etbikehome/Mech_Des_Ornithopter/Peer Critique 1.pdf

# Ornithopter

## Peer Critique 1

## What’s an Ornithopter

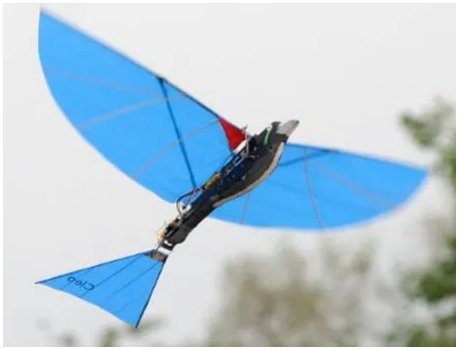
[picture p1: figure]

- A mechanical bird!
- Generates thrust by flapping its wings.
- Subsystems:
- Wings
- Wing Flapping Mech.
- Motor and Gearbox
- Tail

## Functional Requirements

1. Must be able to climb (this means thrust > drag)
2. Should be able to fly for at least 3 minutes on a charge.
3. Must generate its thrust by flapping its wings.
4. Should flap at a rate comparable to a similar size bird.
5. Must have wingspan ~1 meter or less.
6. Must be radio-controlled and maneuverable enough to be flown within the Olin soccer field.
7. Should be able to be re-assembled after a severe crash in 1 day or less.

## Specifications

1. Wing is 1m span by 0.2 m chord
2. From testing: wing draws 20W
3. 200g weight budget
a. From design manual 100W/kg for climb

## Gearbox

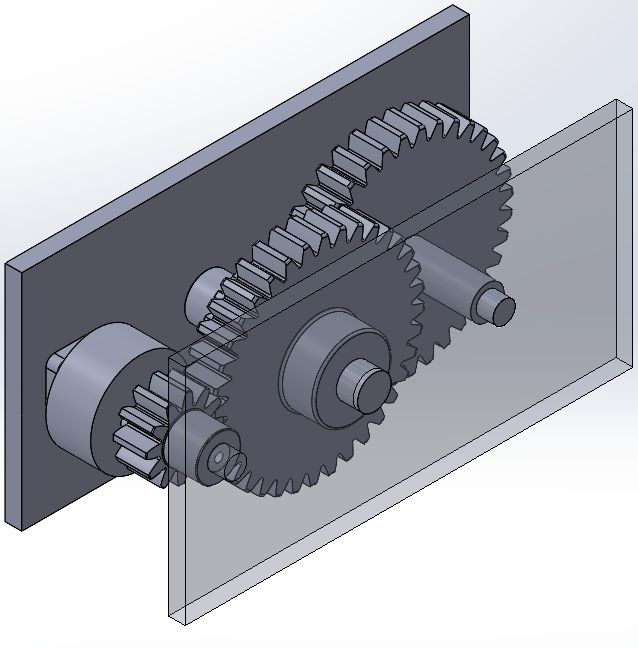
[picture p2: figure]

Requirements:

- Must output 20W at 3 flaps per second with wings attached.
- Must fit within 200g weight budget

Mechanics:

- Acts as fuselage, containing mounting points for other subsystems
- Uses a gear ratio of 9:1 determined from motor power and current calculations, in a 2x3:1 configuration to minimize weight.

## Flapping Mechanism

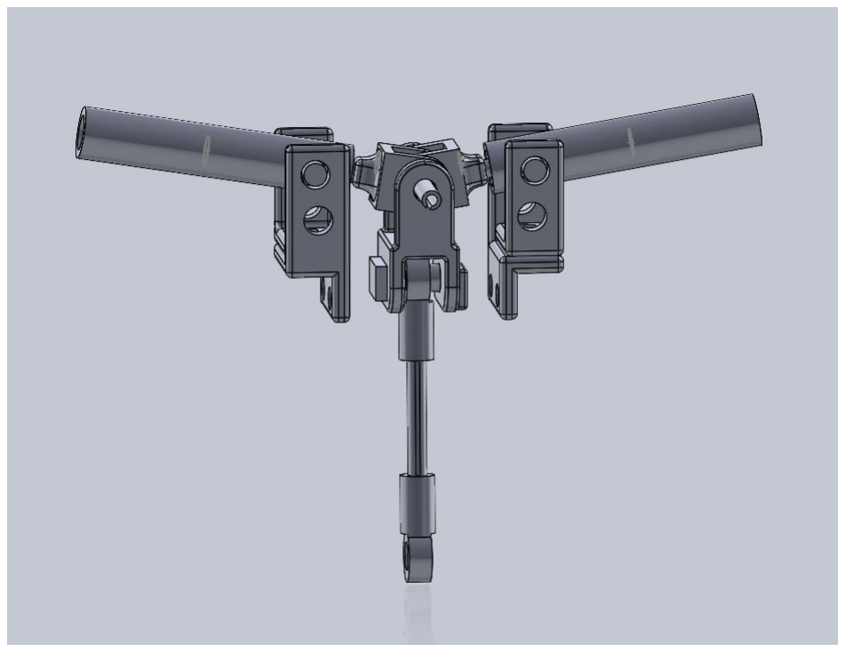
[picture p3: figure]

Requirements:

- Must output 20W at 3 flaps per second with wings attached.
- Must fit within 200g weight budget
- Must provide mostly symmetric flapping

Feedback Points:

- Figuring out better materials (or whether current materials are sufficient)
- Whether heat will be an issue at high speeds
- Maintaining symmetry - is extra support needed? How to implement?

## Tail

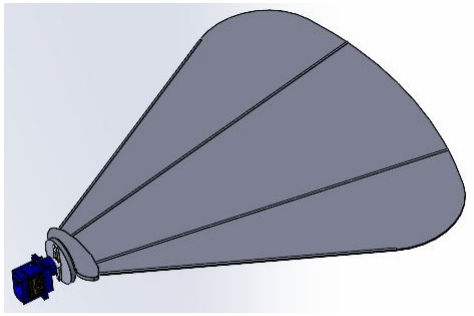
[picture p4: figure]

Requirements

- Must fit within 200g weight budget
- Must be able to rotate to turn
- Must provide stability to flying

## Weight Budget

Calculated using recommended power-weight ratio: 200g

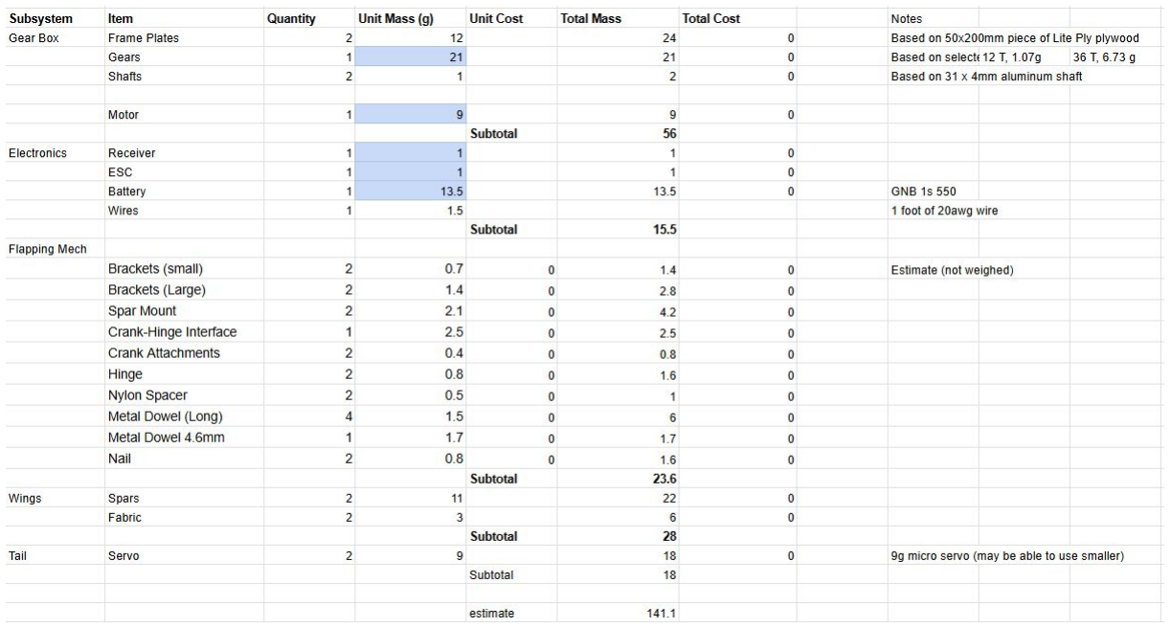
[picture p5: figure]

## Timeline

- We have not yet assembled most hardware (since benchmarking), have a few prototypes made
- We plan to begin assembly next week, aiming to complete it before Thanksgiving break.
