etbikehome/Mech_Des_Ornithopter/Tail/Ornithopter Tail Assembly.SLDASM

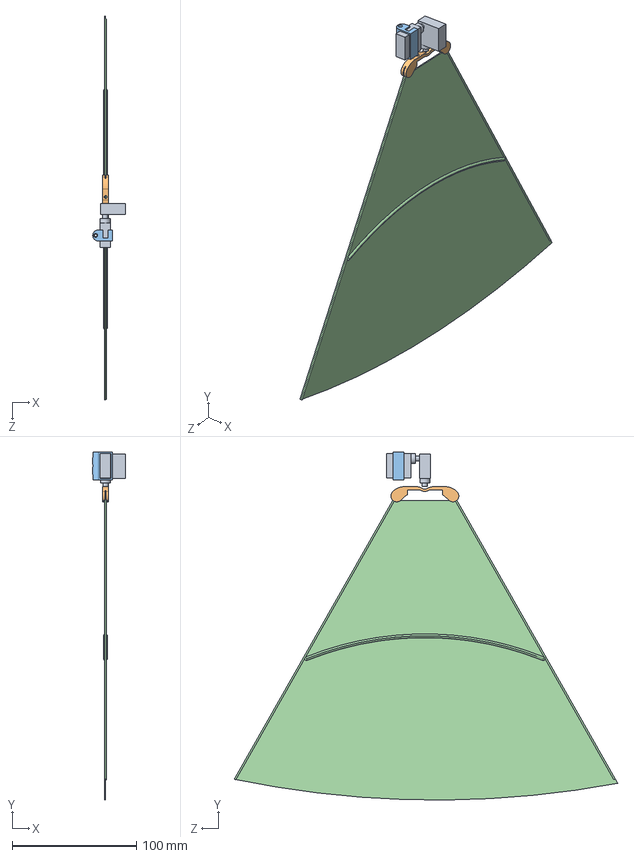
[picture p6: CAD file, 2024-12-20]
Tail/Ornithopter Tail Assembly.SLDASM
26.2 x 280.2 x 308.9 mm
Tail_Ornithopter
Tail Clip rod
Ornithopter Tail Holder 2 with split and support
5.5g Servo x 2
