etbikehome/Mech_Des_Ornithopter/Tail/SG90 - Micro Servo 9g - Tower Pro.SLDASM

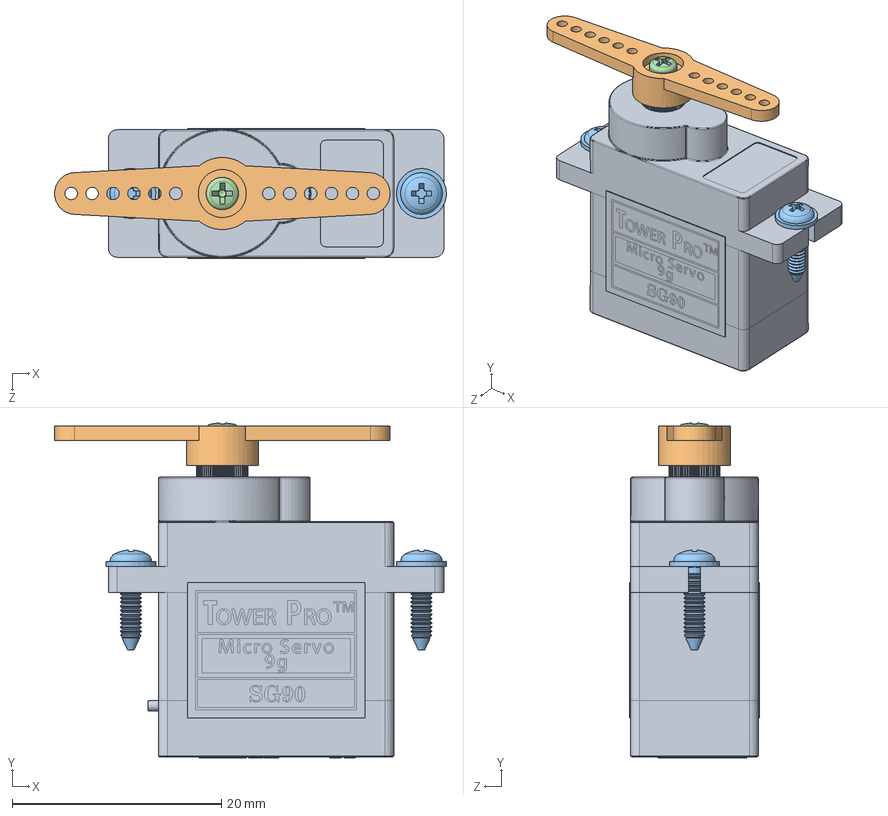
[picture p7: CAD file, 2024-11-21]
Tail/SG90 - Micro Servo 9g - Tower Pro.SLDASM
37.5 x 32.0 x 12.4 mm
SG90 - Micro Servo 9g - Tower Pro.1
SG90 - Micro Servo 9g - Tower Pro.3
SG90 - Micro Servo 9g - Tower Pro.5 x 2
SG90 - Micro Servo 9g - Tower Pro.6
