etbikehome/Mech_Des_Ornithopter/gearbox/Gearbox.SLDASM

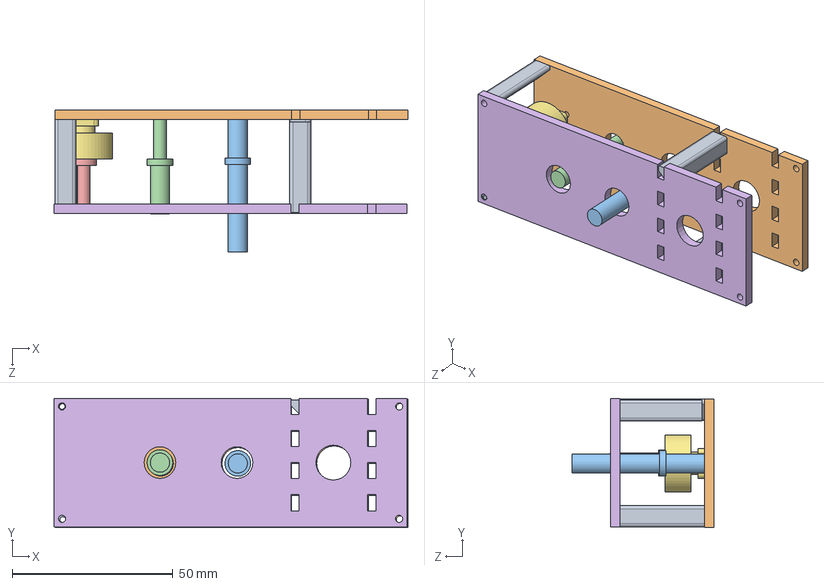
[picture p8: CAD file, 2024-11-30]
gearbox/Gearbox.SLDASM
110.2 x 40.2 x 44.2 mm
motor_1404
sideplateA
motor_adaptor_shaft
step_shaft
single_6mm_shaft
sideplateB
gearbox_standoff x 4
