etbikehome/Mech_Des_Ornithopter/gearbox/Gears/sideplateA.DXF

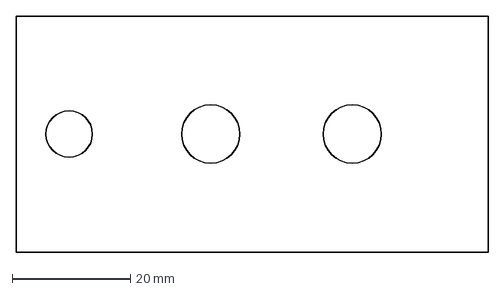
[picture p9: CAD file, 2024-11-18]
gearbox/Gears/sideplateA.DXF
80.0 x 40.0 mm
