etbikehome/Mech_Des_Ornithopter/Hinge Flapping Mechanism/flapping_mech_frames_v2.SLDPRT

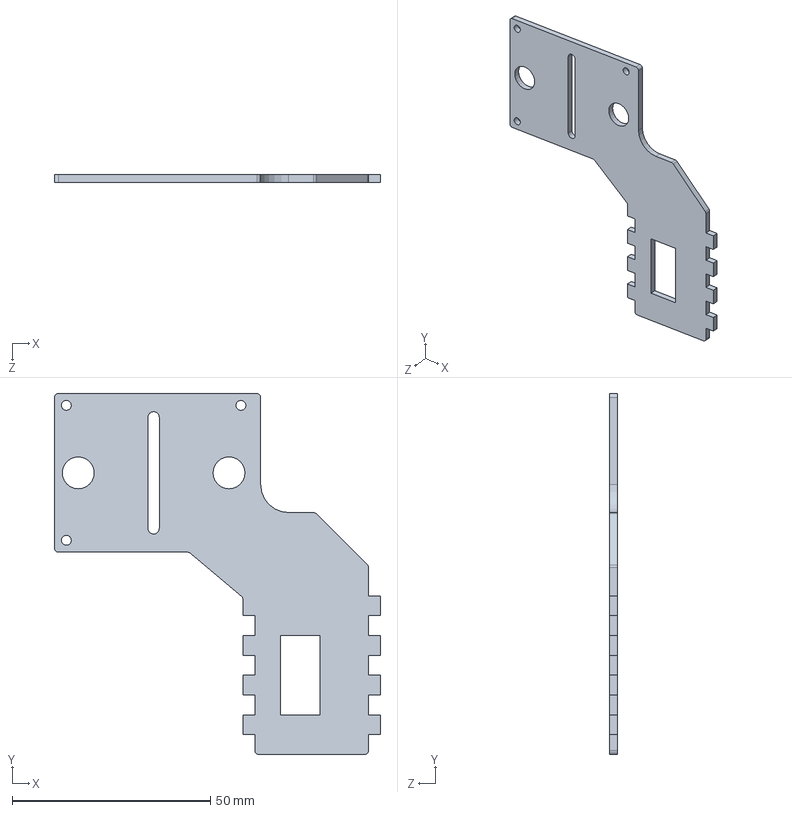
[picture p10: CAD file, 2024-12-19]
Hinge Flapping Mechanism/flapping_mech_frames_v2.SLDPRT
82.2 x 91.0 x 2.00 mm
