etbikehome/Mech_Des_Ornithopter/Tail/Ornithopter Tail Holder 2 with split and support.SLDPRT

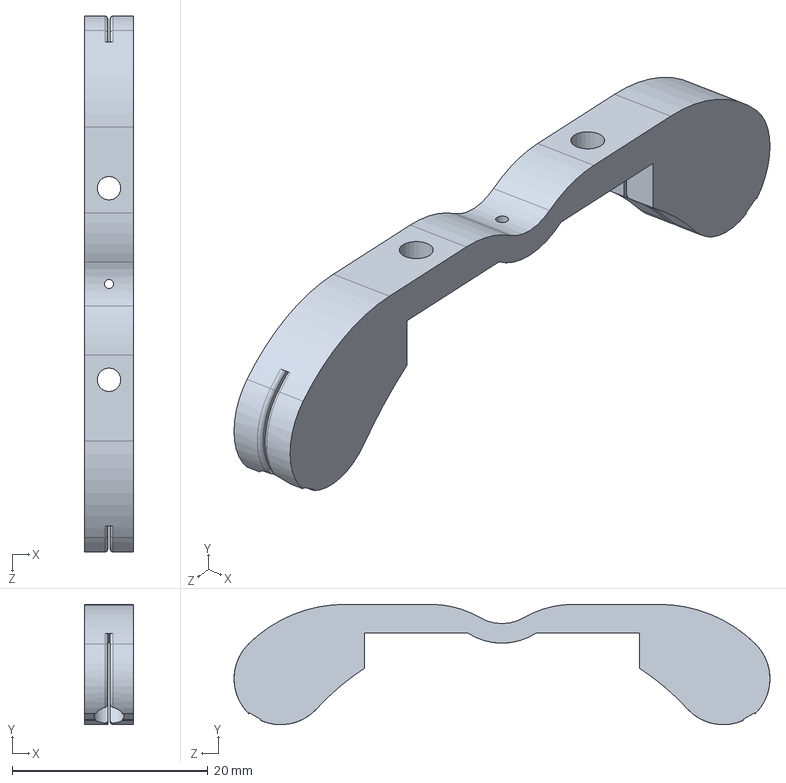
[picture p11: CAD file, 2024-12-14]
Tail/Ornithopter Tail Holder 2 with split and support.SLDPRT
5.00 x 12.3 x 54.8 mm
