etbikehome/Mech_Des_Ornithopter/gearbox/sideplateA.SLDPRT

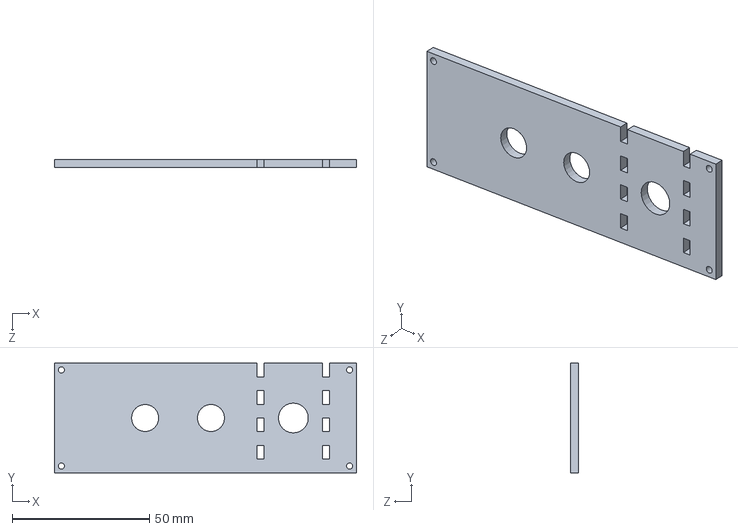
[picture p12: CAD file, 2024-12-13]
gearbox/sideplateA.SLDPRT
110.0 x 40.0 x 3.00 mm
