etbikehome/Mech_Des_Ornithopter/Hinge Flapping Mechanism/spar_hinge_interface_v3.SLDPRT

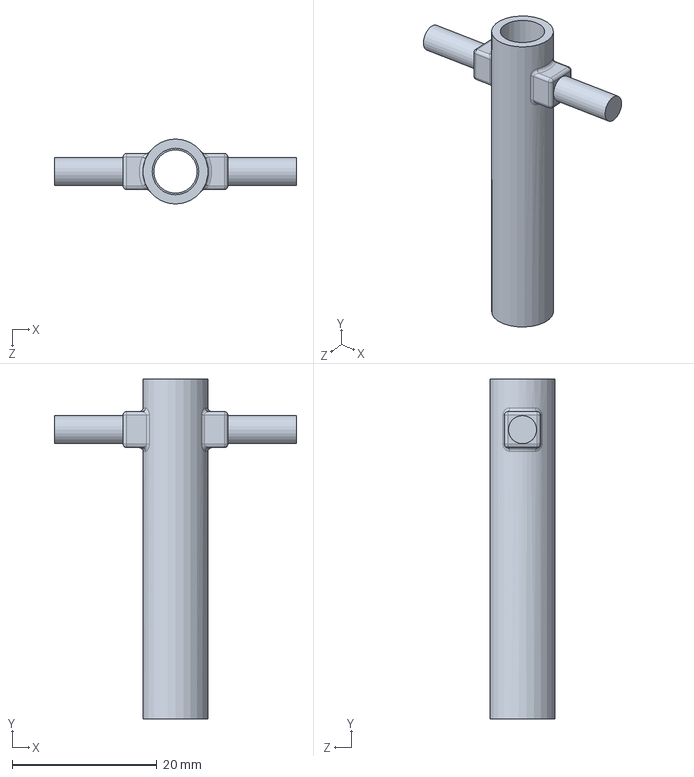
[picture p13: CAD file, 2024-12-18]
Hinge Flapping Mechanism/spar_hinge_interface_v3.SLDPRT
33.5 x 47.0 x 9.00 mm
