etbikehome/Mech_Des_Ornithopter/Tail/Tail_Ornithopter.SLDPRT

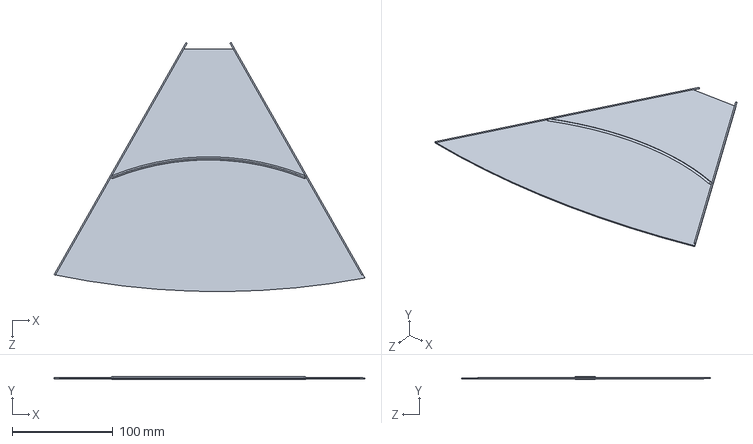
[picture p14: CAD file, 2024-12-14]
Tail/Tail_Ornithopter.SLDPRT
308.9 x 3.00 x 247.4 mm
