etbikehome/Mech_Des_Ornithopter/gearbox/gearbox_standoff.SLDPRT

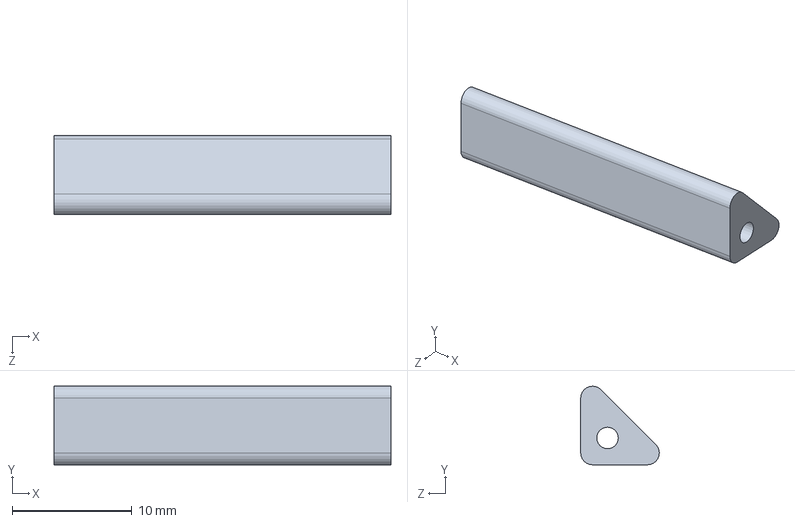
[picture p15: CAD file, 2024-12-13]
gearbox/gearbox_standoff.SLDPRT
28.2 x 6.59 x 6.59 mm
