etbikehome/Mech_Des_Ornithopter/Hinge Flapping Mechanism/plate_connector_tail_mount.SLDPRT

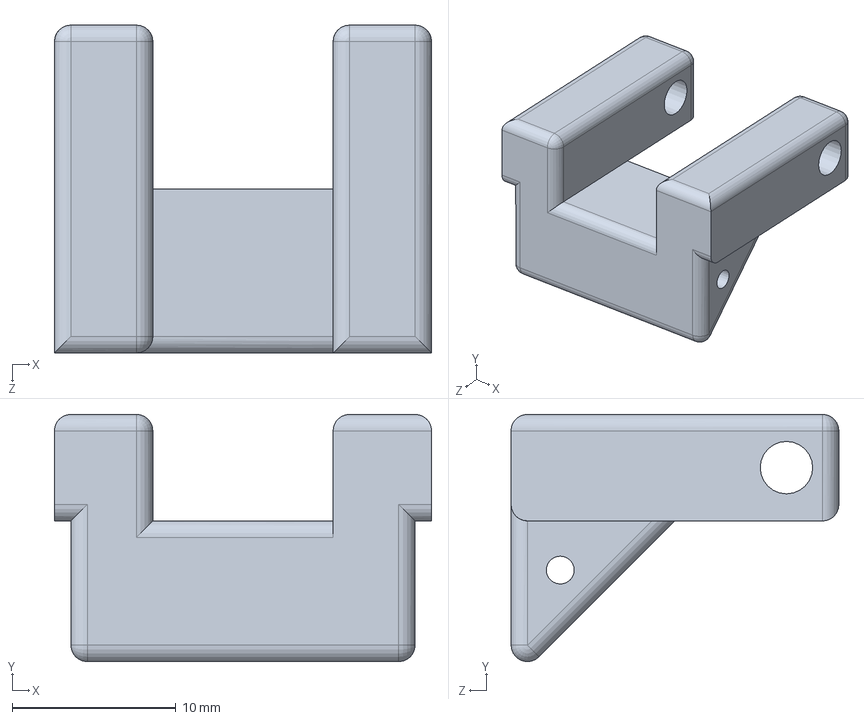
[picture p16: CAD file, 2024-12-11]
Hinge Flapping Mechanism/plate_connector_tail_mount.SLDPRT
23.0 x 15.1 x 20.0 mm
