etbikehome/Mech_Des_Ornithopter/Tail/5.5g Servo.SLDPRT

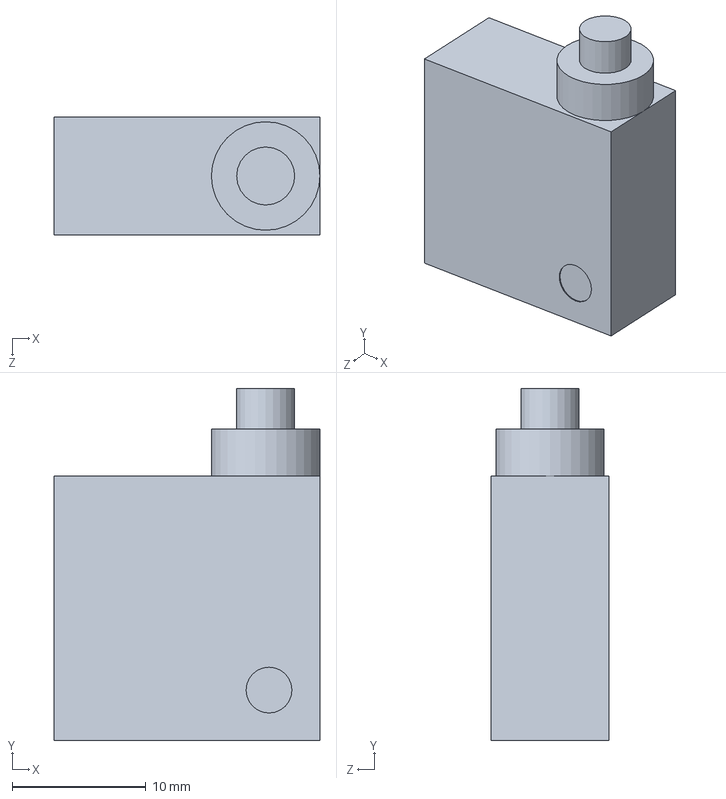
[picture p17: CAD file, 2024-12-13]
Tail/5.5g Servo.SLDPRT
19.9 x 26.4 x 8.80 mm
