etbikehome/Mech_Des_Ornithopter/gearbox/motor_1404.SLDPRT

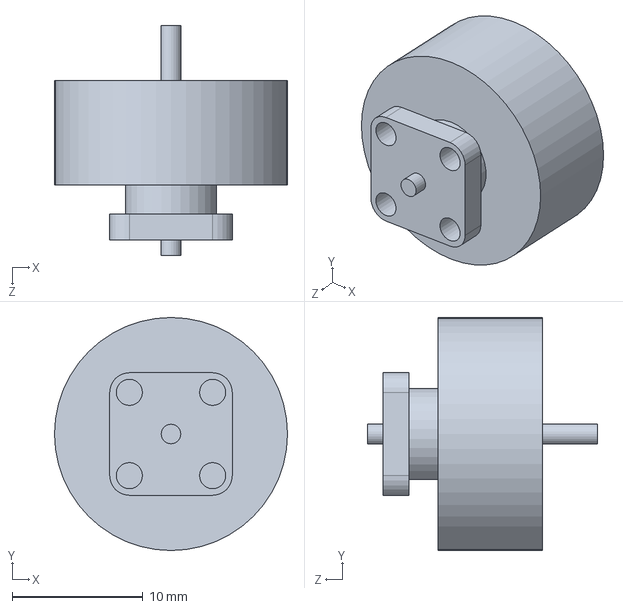
[picture p18: CAD file, 2024-12-09]
gearbox/motor_1404.SLDPRT
17.8 x 17.8 x 17.6 mm
