etbikehome/Mech_Des_Ornithopter/Hinge Flapping Mechanism/metal_crank_cap.SLDPRT

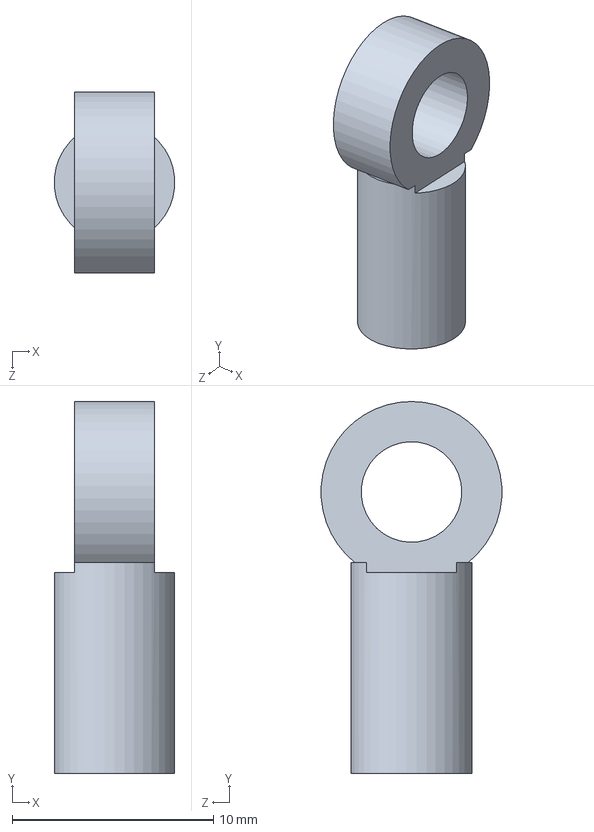
[picture p19: CAD file, 2024-12-11]
Hinge Flapping Mechanism/metal_crank_cap.SLDPRT
5.98 x 18.5 x 8.98 mm
