etbikehome/Mech_Des_Ornithopter/Tail/tail_rod.SLDPRT

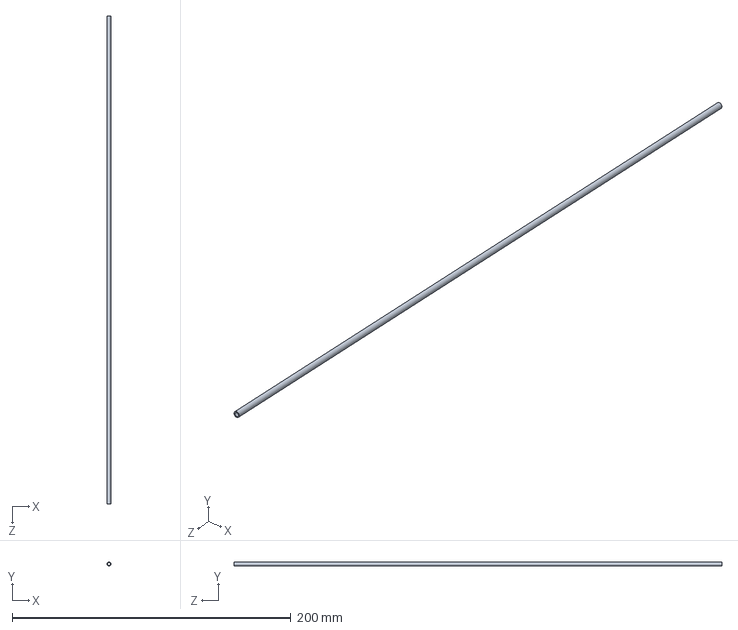
[picture p20: CAD file, 2024-12-13]
Tail/tail_rod.SLDPRT
3.00 x 3.00 x 350.0 mm
