etbikehome/Mech_Des_Ornithopter/gearbox/EMAX 2004 MOTOR.sldprt

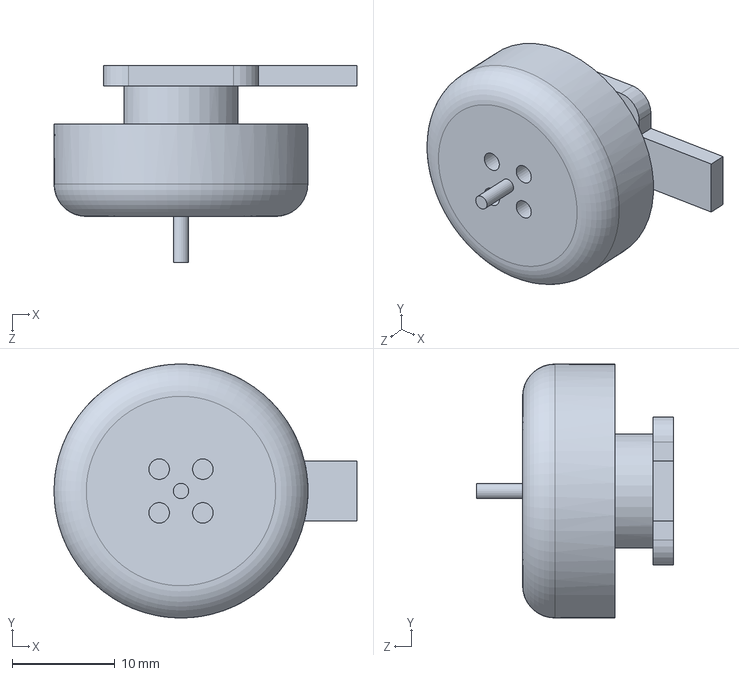
[picture p21: CAD file, 2024-12-09]
gearbox/EMAX 2004 MOTOR.sldprt
29.5 x 24.7 x 19.2 mm
