etbikehome/Mech_Des_Ornithopter/Hinge Flapping Mechanism/flapping_mech_frames_v2_no_hole.SLDPRT

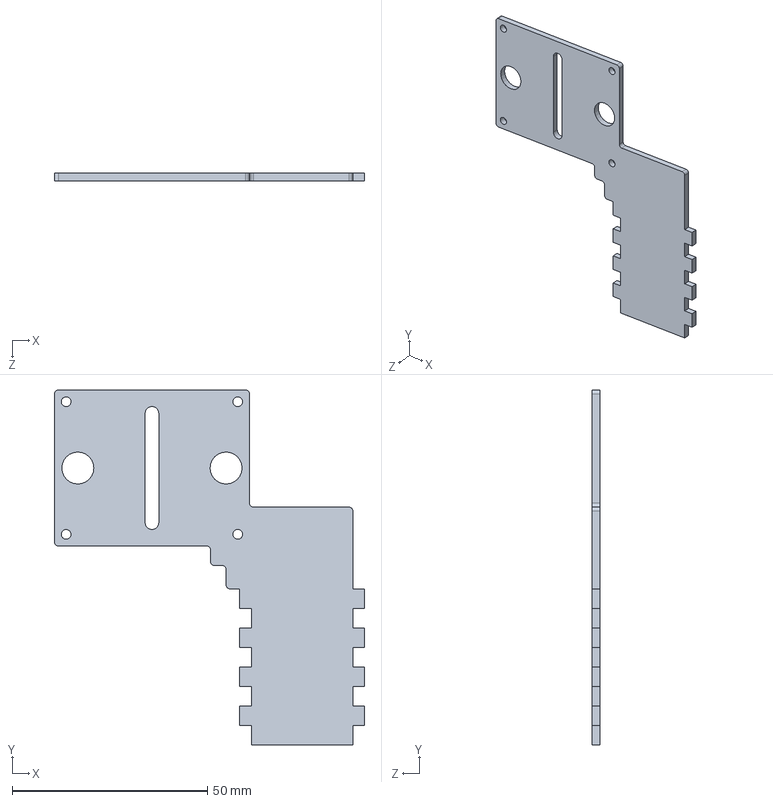
[picture p22: CAD file, 2024-12-05]
Hinge Flapping Mechanism/flapping_mech_frames_v2_no_hole.SLDPRT
79.5 x 91.0 x 2.00 mm
