etbikehome/Mech_Des_Ornithopter/Tail/Tail Clip rod.SLDPRT

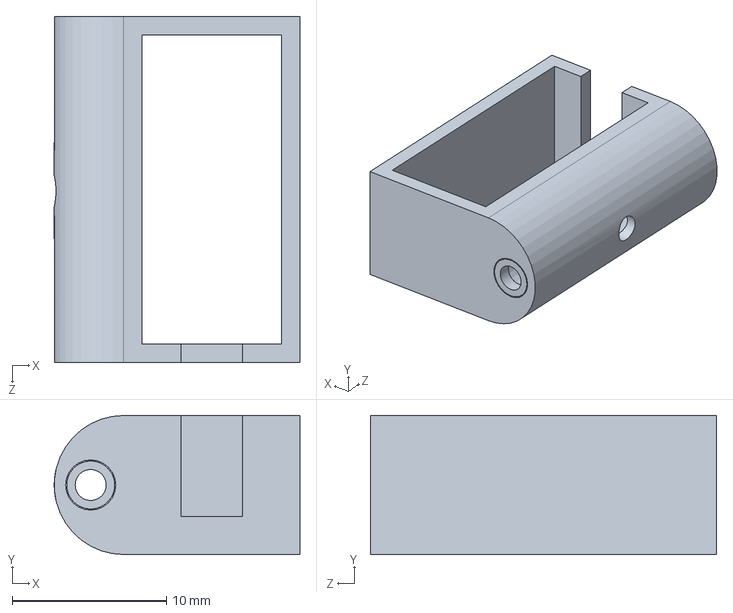
[picture p23: CAD file, 2024-12-13]
Tail/Tail Clip rod.SLDPRT
15.9 x 9.00 x 22.4 mm
