etbikehome/Mech_Des_Ornithopter/gearbox/4mm_shaft_bushing.SLDPRT

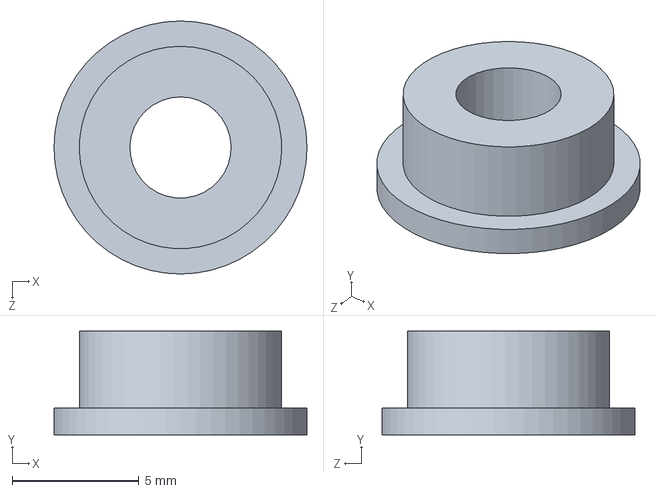
[picture p24: CAD file, 2024-12-09]
gearbox/4mm_shaft_bushing.SLDPRT
10.0 x 4.10 x 10.0 mm
