etbikehome/Mech_Des_Ornithopter/Hinge Flapping Mechanism/wing_fabric.SLDPRT

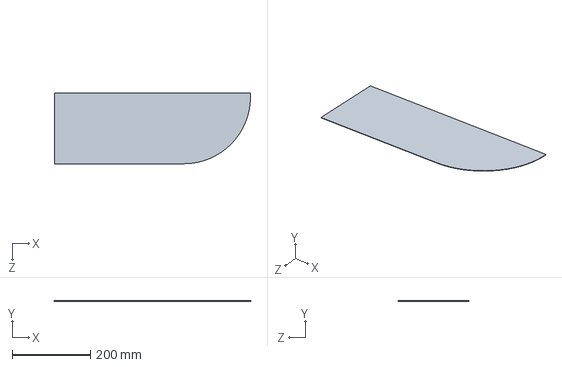
[picture p25: CAD file, 2024-12-05]
Hinge Flapping Mechanism/wing_fabric.SLDPRT
500.0 x 1.00 x 180.0 mm
