etbikehome/Mech_Des_Ornithopter/gearbox/sideplateB.SLDPRT

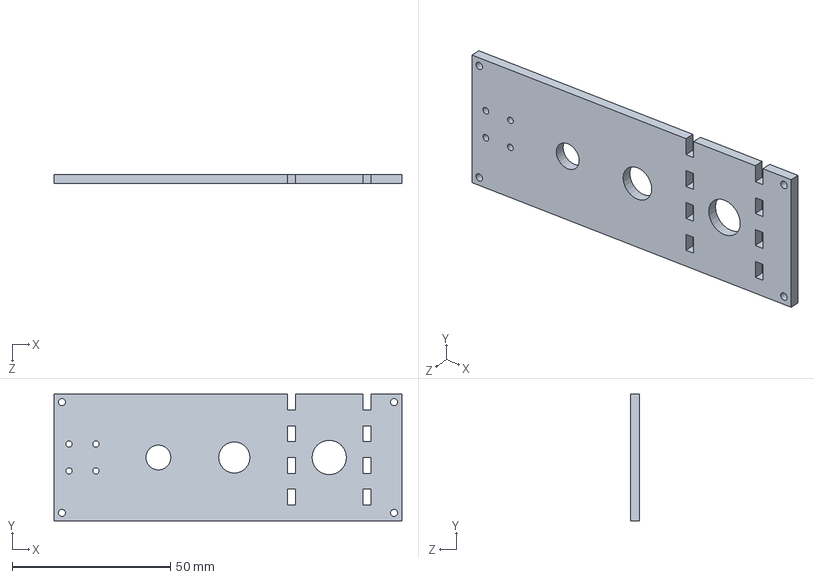
[picture p26: CAD file, 2024-12-09]
gearbox/sideplateB.SLDPRT
110.0 x 40.0 x 3.00 mm
