etbikehome/Mech_Des_Ornithopter/Tail/Ornithopter Tail Holder.SLDPRT

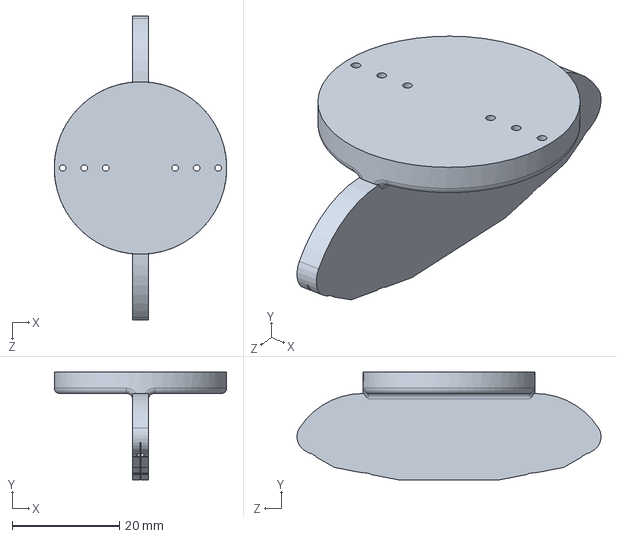
[picture p27: CAD file, 2024-11-18]
Tail/Ornithopter Tail Holder.SLDPRT
32.1 x 20.1 x 56.6 mm
