etbikehome/Mech_Des_Ornithopter/gearbox/8mm_shaft_bushing.SLDPRT

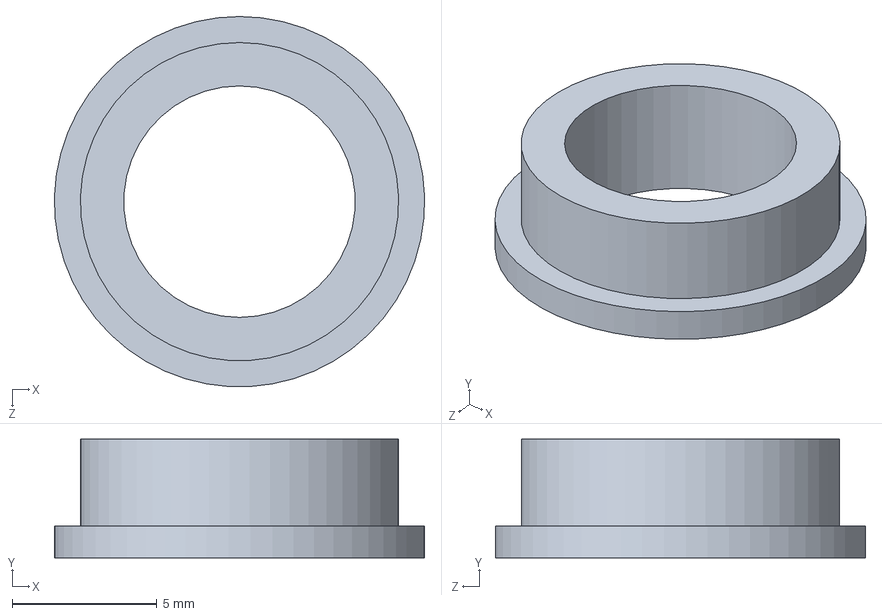
[picture p28: CAD file, 2024-12-09]
gearbox/8mm_shaft_bushing.SLDPRT
12.8 x 4.10 x 12.8 mm
