etbikehome/Mech_Des_Ornithopter/Hinge Flapping Mechanism/crank_v2.SLDPRT

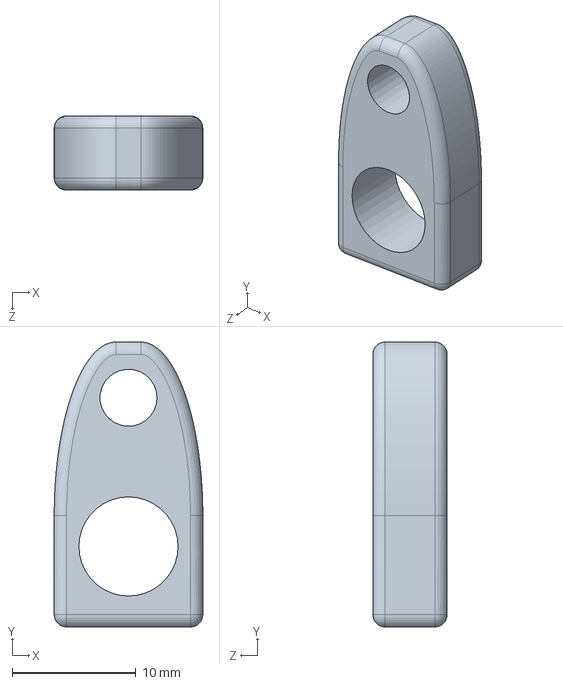
[picture p29: CAD file, 2024-12-04]
Hinge Flapping Mechanism/crank_v2.SLDPRT
12.0 x 23.0 x 6.00 mm
