etbikehome/Mech_Des_Ornithopter/Tail/SG90 - Micro Servo 9g - Tower Pro.5.SLDPRT

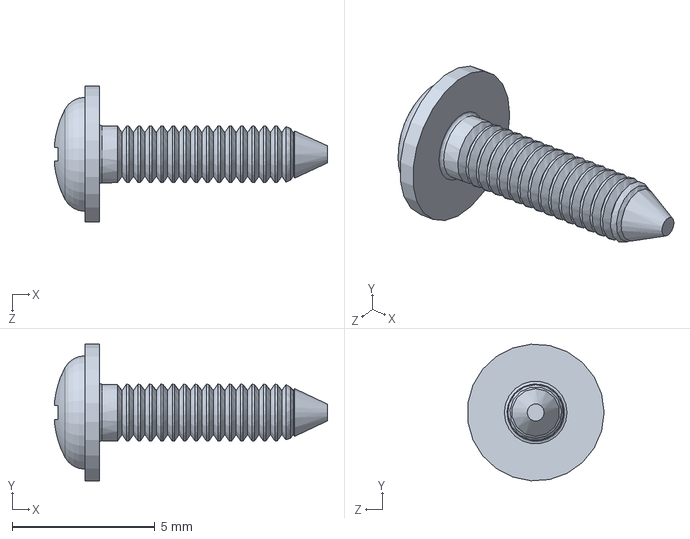
[picture p30: CAD file, 2024-11-18]
Tail/SG90 - Micro Servo 9g - Tower Pro.5.SLDPRT
9.57 x 4.79 x 4.78 mm
