etbikehome/Mech_Des_Ornithopter/gearbox/6mm_shaft_bushing.SLDPRT

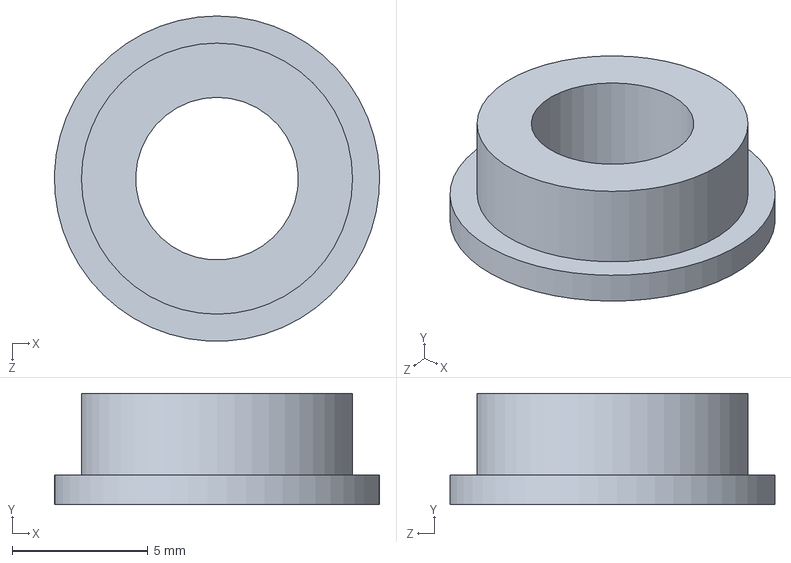
[picture p31: CAD file, 2024-12-09]
gearbox/6mm_shaft_bushing.SLDPRT
12.0 x 4.10 x 12.0 mm
