etbikehome/Mech_Des_Ornithopter/Hinge Flapping Mechanism/plate_connector.SLDPRT

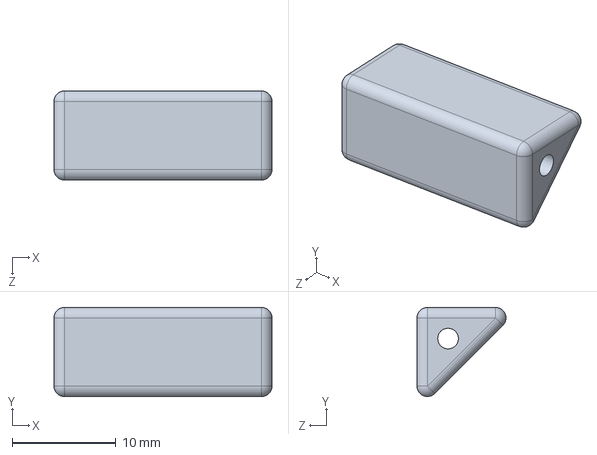
[picture p32: CAD file, 2024-12-04]
Hinge Flapping Mechanism/plate_connector.SLDPRT
21.0 x 8.59 x 8.59 mm
