etbikehome/Mech_Des_Ornithopter/Tail/SG90 - Micro Servo 9g - Tower Pro.6.SLDPRT

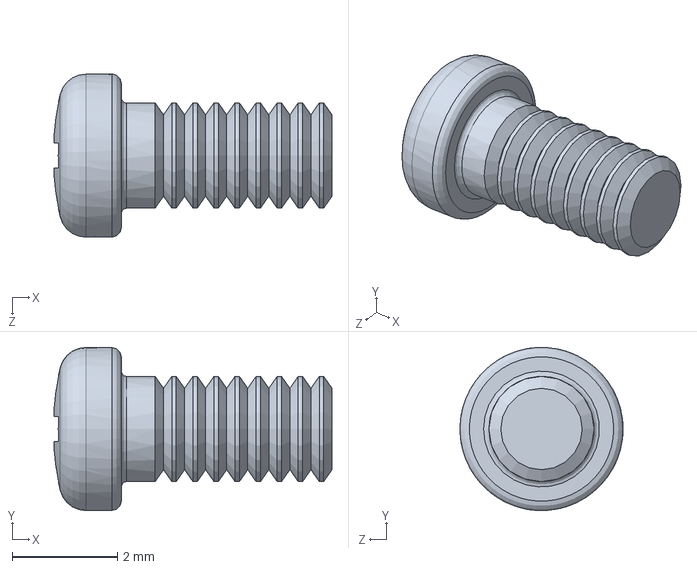
[picture p33: CAD file, 2024-11-18]
Tail/SG90 - Micro Servo 9g - Tower Pro.6.SLDPRT
5.28 x 3.10 x 3.10 mm
