etbikehome/Mech_Des_Ornithopter/gearbox/final_stage_shaft.SLDPRT

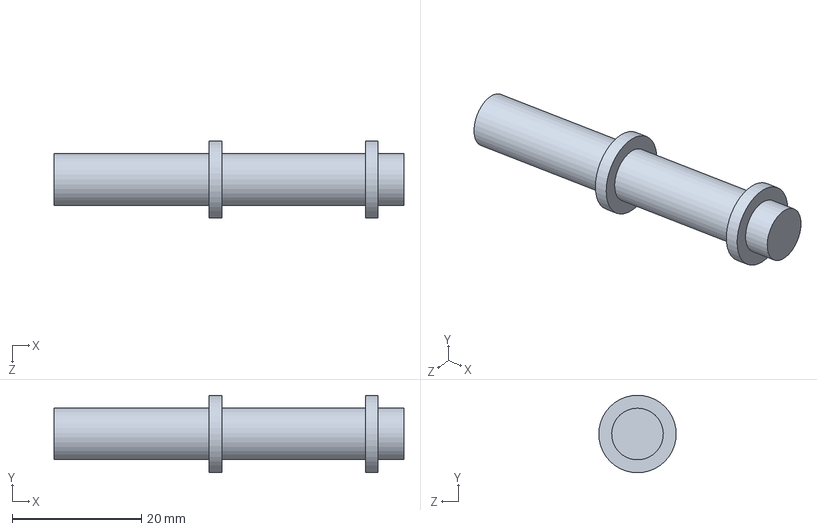
[picture p34: CAD file, 2024-12-05]
gearbox/final_stage_shaft.SLDPRT
54.2 x 12.0 x 12.0 mm
