etbikehome/Mech_Des_Ornithopter/Hinge Flapping Mechanism/crank_linkage_drive.SLDPRT

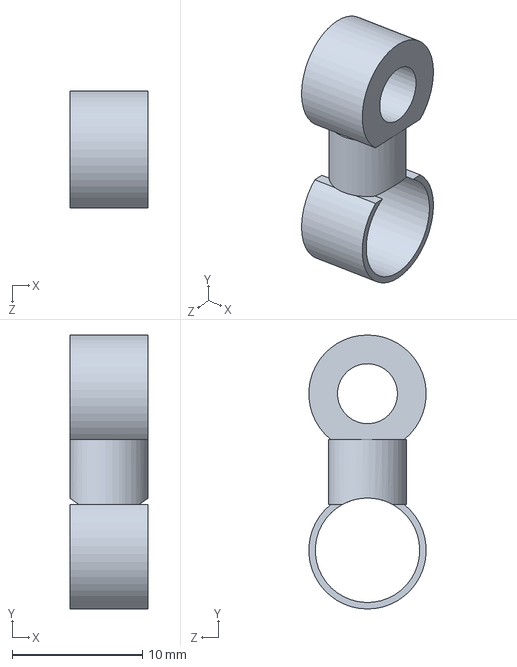
[picture p35: CAD file, 2024-12-02]
Hinge Flapping Mechanism/crank_linkage_drive.SLDPRT
6.00 x 21.0 x 8.98 mm
