etbikehome/Mech_Des_Ornithopter/Tail/SG90 - Micro Servo 9g - Tower Pro.3.SLDPRT

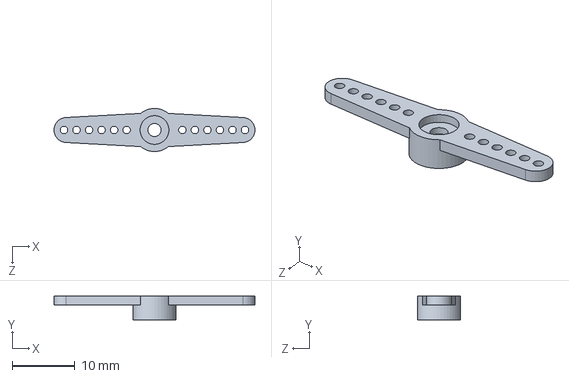
[picture p36: CAD file, 2024-11-18]
Tail/SG90 - Micro Servo 9g - Tower Pro.3.SLDPRT
32.1 x 3.80 x 6.90 mm
