etbikehome/Mech_Des_Ornithopter/Hinge Flapping Mechanism/46_pin.SLDPRT

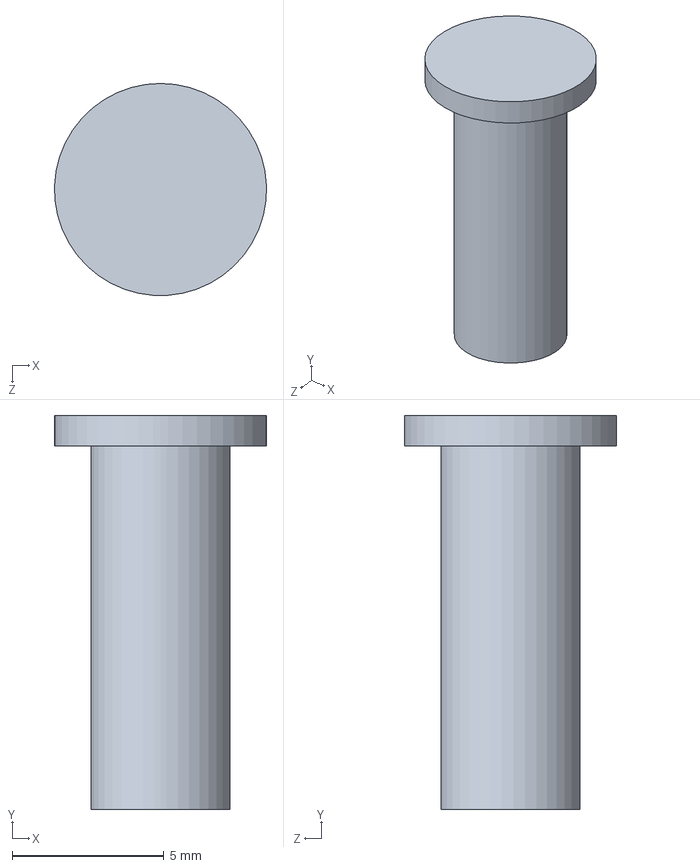
[picture p37: CAD file, 2024-12-02]
Hinge Flapping Mechanism/46_pin.SLDPRT
7.00 x 13.0 x 7.00 mm
