etbikehome/Mech_Des_Ornithopter/Tail/SG90 - Micro Servo 9g - Tower Pro.1.SLDPRT

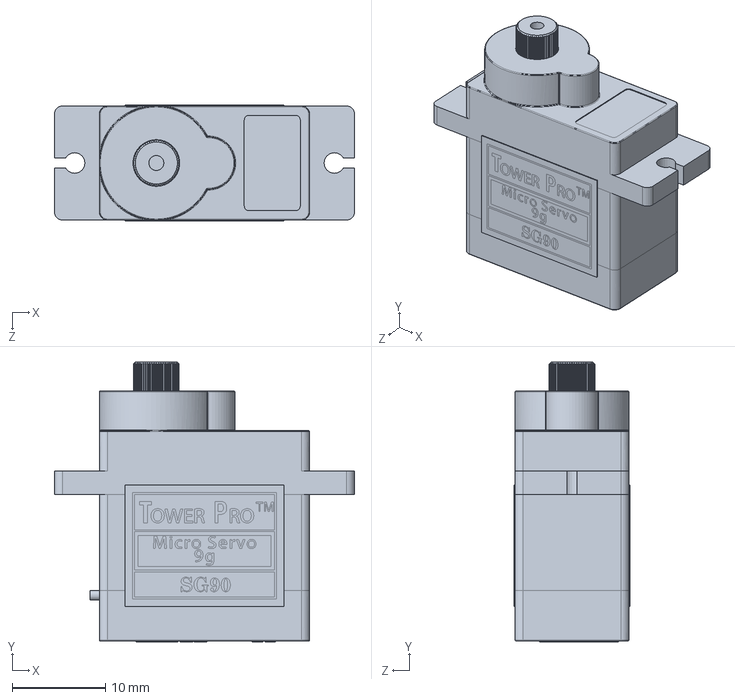
[picture p38: CAD file, 2024-11-18]
Tail/SG90 - Micro Servo 9g - Tower Pro.1.SLDPRT
32.1 x 30.0 x 12.4 mm
