etbikehome/Mech_Des_Ornithopter/gearbox/step_shaft.SLDPRT

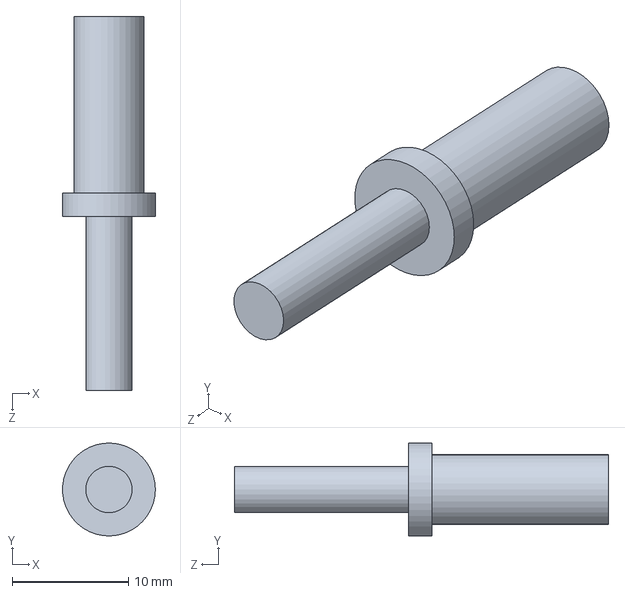
[picture p39: CAD file, 2024-12-02]
gearbox/step_shaft.SLDPRT
7.99 x 7.99 x 32.2 mm
