etbikehome/Mech_Des_Ornithopter/Hinge Flapping Mechanism/delrin_bushing.SLDPRT

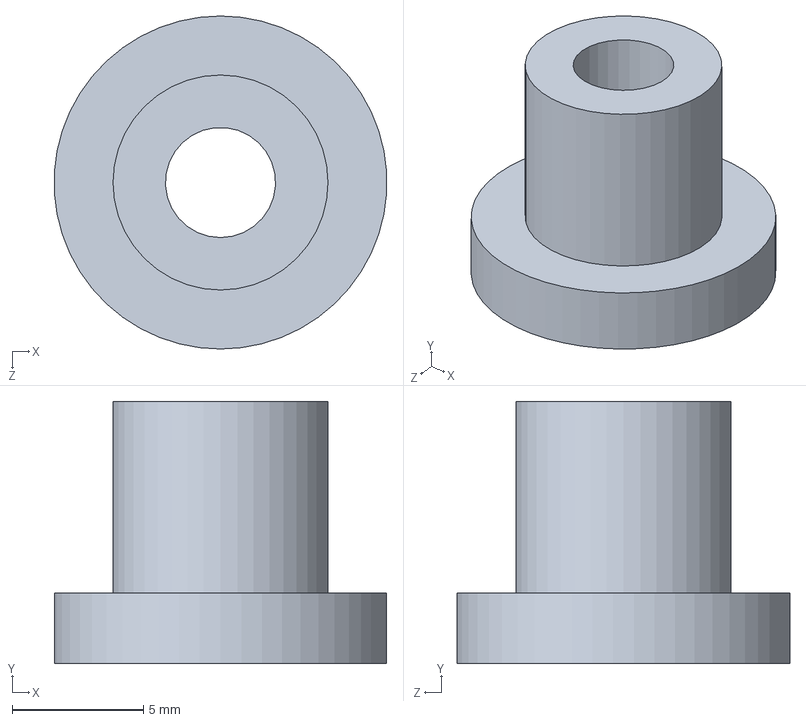
[picture p40: CAD file, 2024-11-21]
Hinge Flapping Mechanism/delrin_bushing.SLDPRT
12.7 x 10.0 x 12.7 mm
