etbikehome/Mech_Des_Ornithopter/gearbox/single_6mm_shaft.SLDPRT

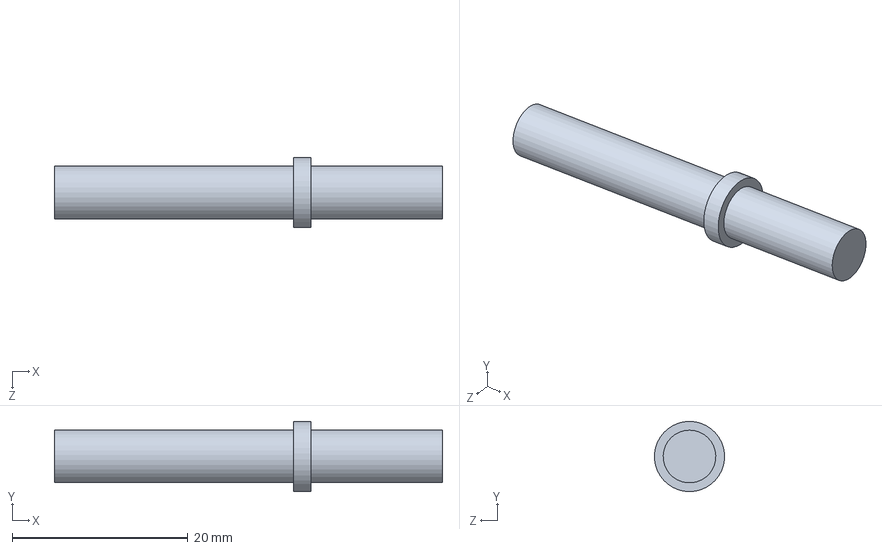
[picture p41: CAD file, 2024-12-02]
gearbox/single_6mm_shaft.SLDPRT
44.2 x 8.00 x 7.97 mm
