etbikehome/Mech_Des_Ornithopter/Hinge Flapping Mechanism/metal_dowel_33_cut.SLDPRT

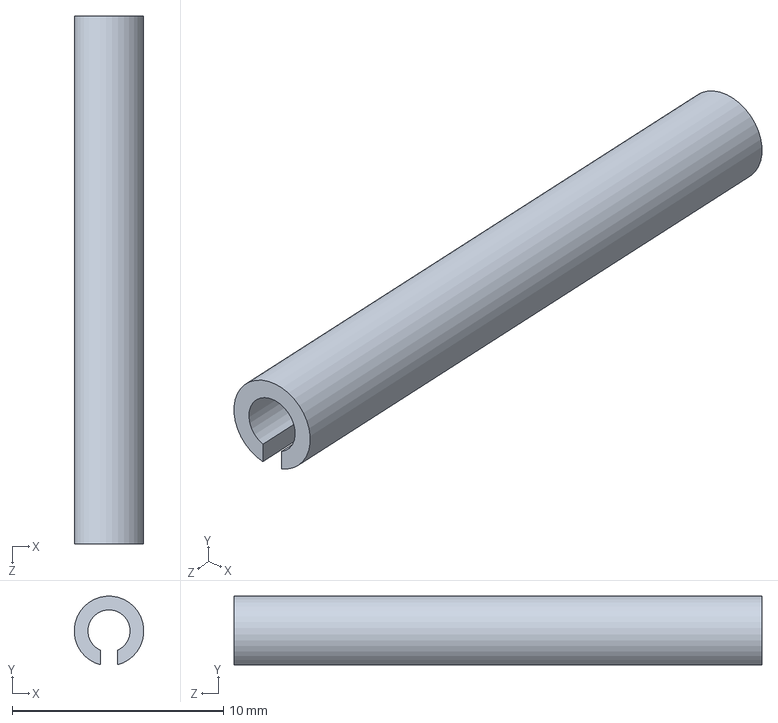
[picture p42: CAD file, 2024-11-21]
Hinge Flapping Mechanism/metal_dowel_33_cut.SLDPRT
3.29 x 3.24 x 25.0 mm
