etbikehome/Mech_Des_Ornithopter/Hinge Flapping Mechanism/metal_dowel_4.SLDPRT

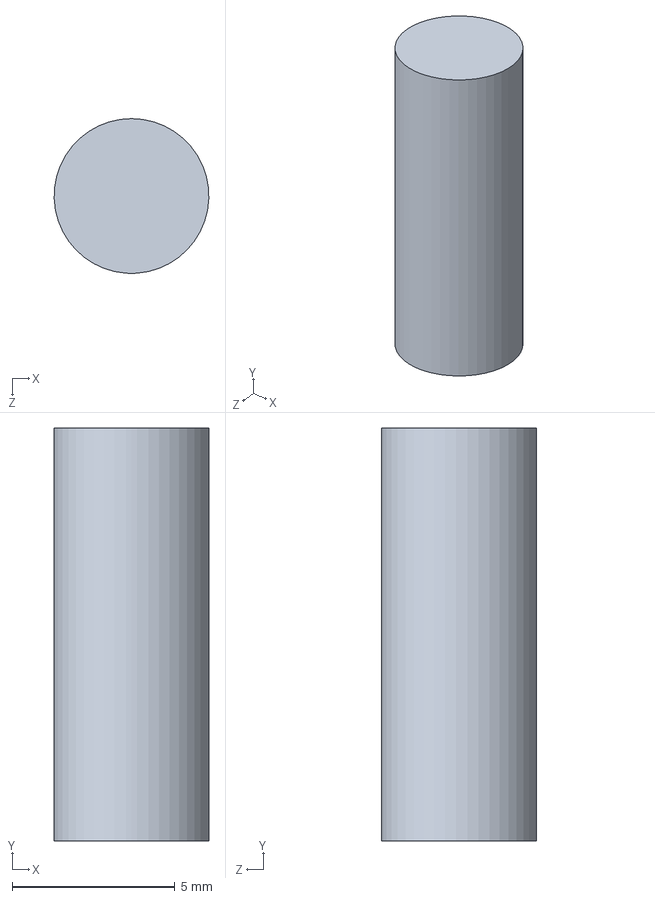
[picture p43: CAD file, 2024-11-18]
Hinge Flapping Mechanism/metal_dowel_4.SLDPRT
4.76 x 12.7 x 4.76 mm
