etbikehome/Mech_Des_Ornithopter/Hinge Flapping Mechanism/plastic_spacer_shorter.SLDPRT

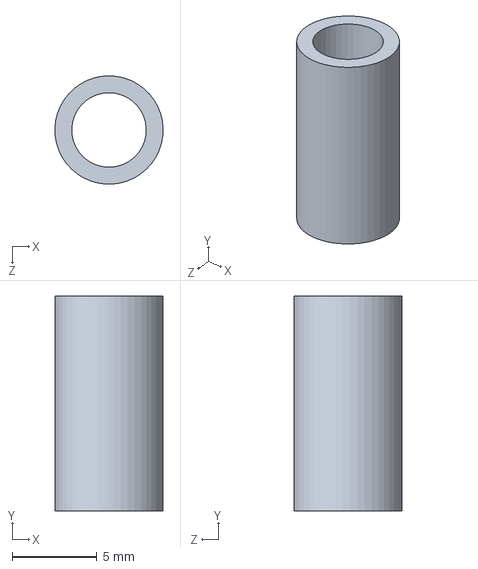
[picture p44: CAD file, 2024-11-18]
Hinge Flapping Mechanism/plastic_spacer_shorter.SLDPRT
6.40 x 12.7 x 6.40 mm
