etbikehome/Mech_Des_Ornithopter/Hinge Flapping Mechanism/metal_dowel_40.SLDPRT

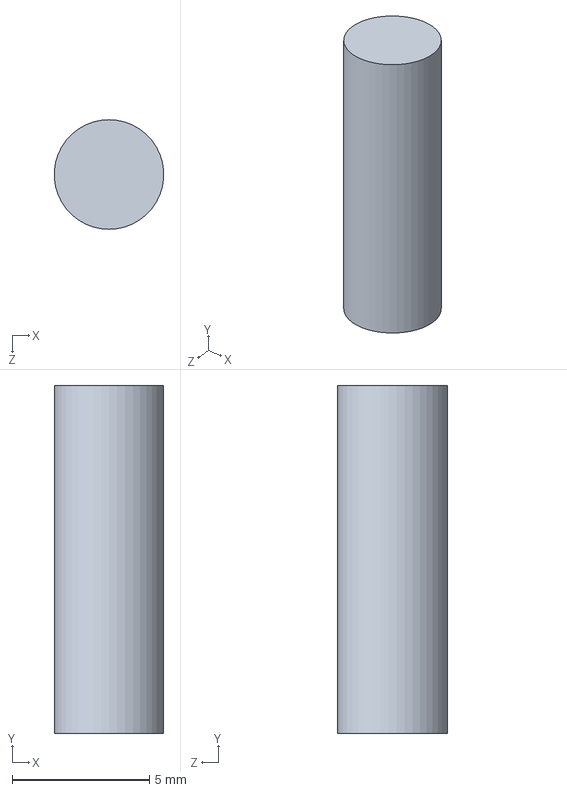
[picture p45: CAD file, 2024-11-18]
Hinge Flapping Mechanism/metal_dowel_40.SLDPRT
3.99 x 12.7 x 4.00 mm
