etbikehome/Mech_Des_Ornithopter/Hinge Flapping Mechanism/bushing_mount.SLDPRT

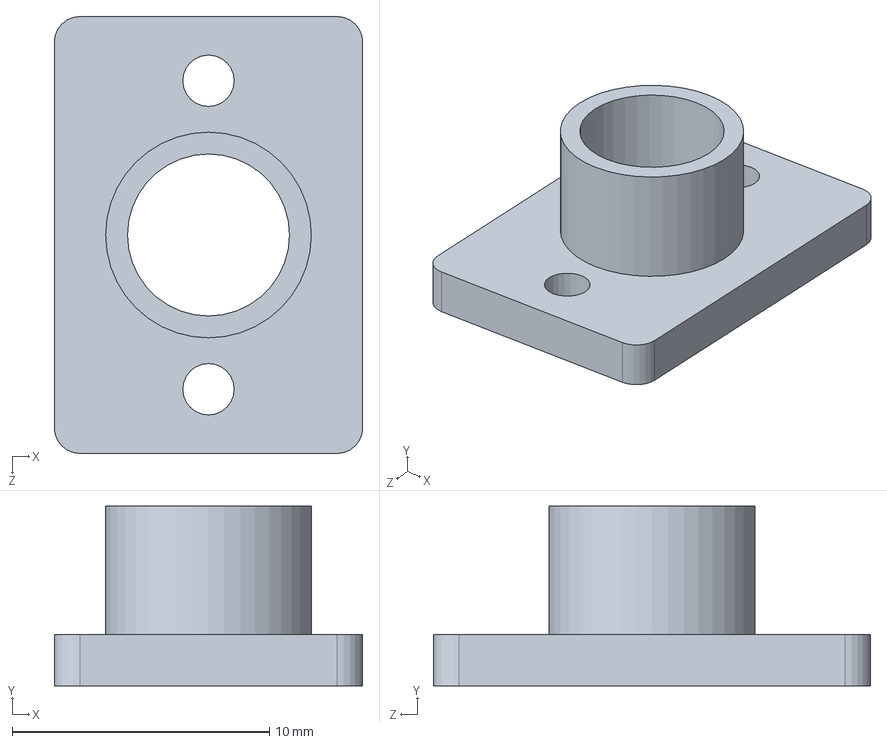
[picture p46: CAD file, 2024-11-18]
Hinge Flapping Mechanism/bushing_mount.SLDPRT
12.0 x 7.00 x 17.0 mm
