etbikehome/Mech_Des_Ornithopter/gearbox/motor_adaptor_shaft.SLDPRT

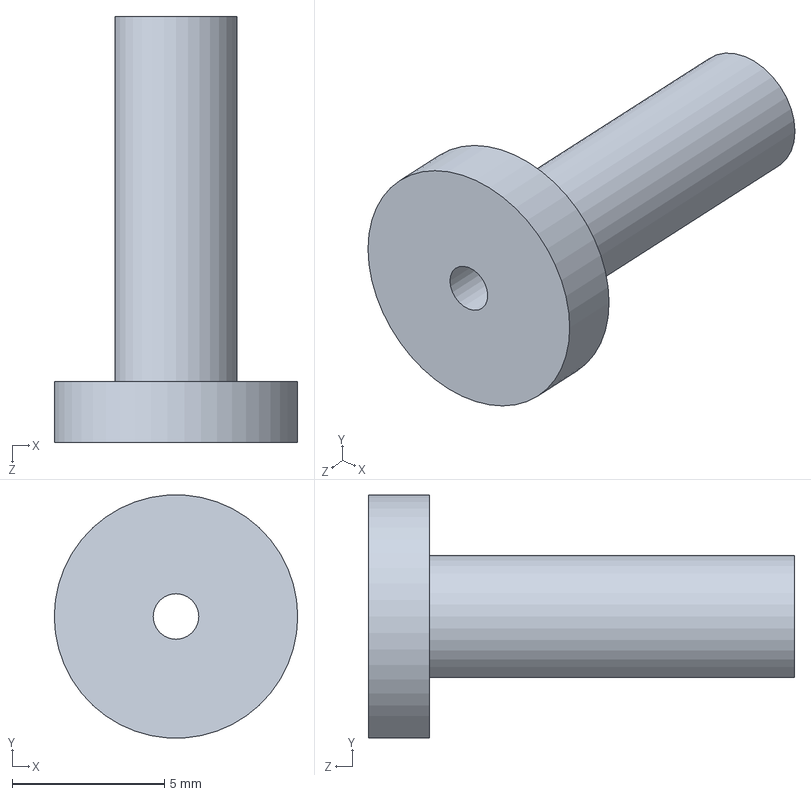
[picture p47: CAD file, 2024-11-18]
gearbox/motor_adaptor_shaft.SLDPRT
8.00 x 7.98 x 14.0 mm
