etbikehome/Mech_Des_Ornithopter/Hinge Flapping Mechanism/metal_crank_cap_linkside.SLDPRT

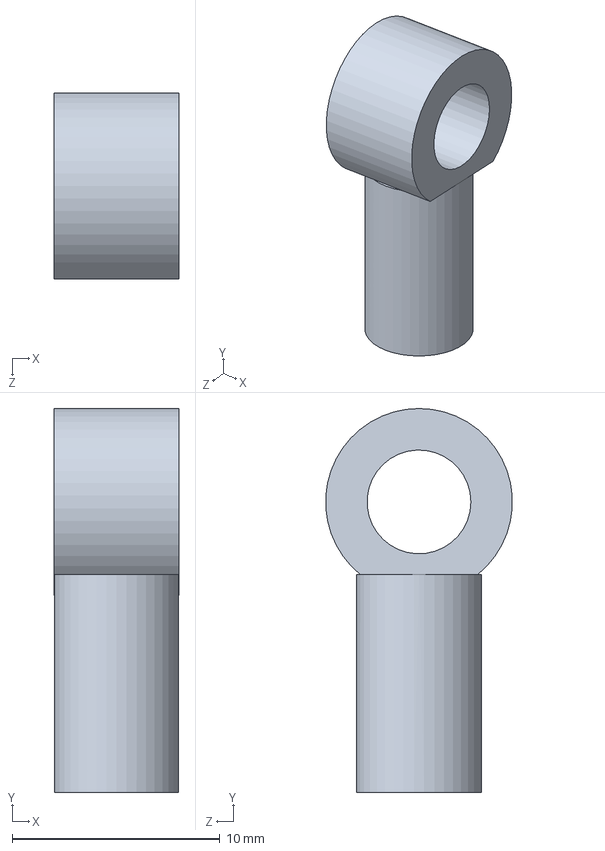
[picture p48: CAD file, 2024-11-18]
Hinge Flapping Mechanism/metal_crank_cap_linkside.SLDPRT
6.00 x 18.5 x 8.98 mm
