etbikehome/Mech_Des_Ornithopter/Hinge Flapping Mechanism/cranke_joint_hinge1v2.SLDPRT

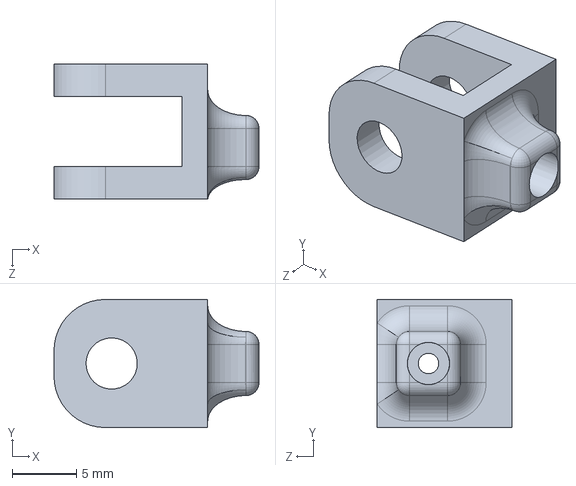
[picture p49: CAD file, 2024-11-18]
Hinge Flapping Mechanism/cranke_joint_hinge1v2.SLDPRT
16.0 x 10.0 x 10.5 mm
