etbikehome/Mech_Des_Ornithopter/Hinge Flapping Mechanism/metal_dowel_33.SLDPRT

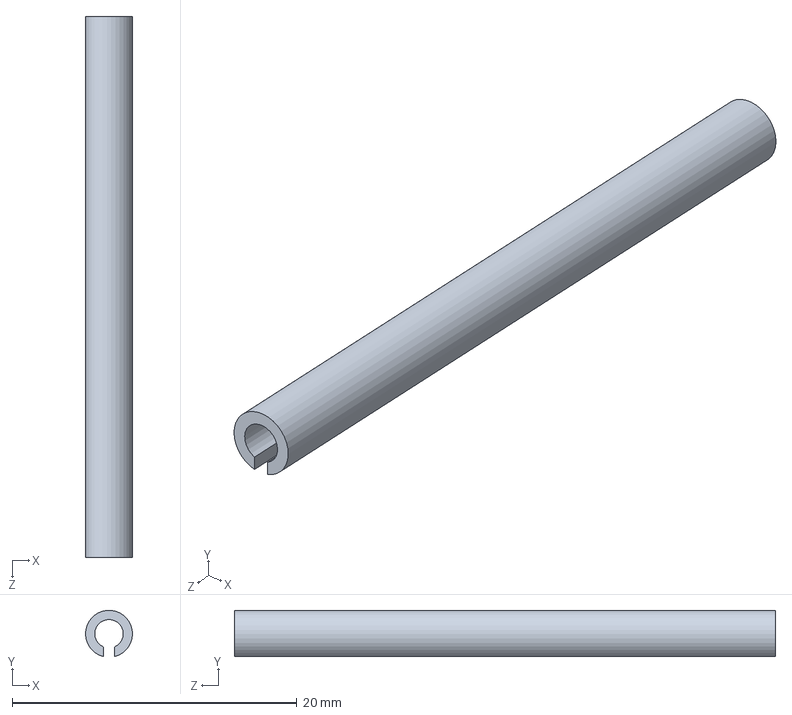
[picture p50: CAD file, 2024-11-18]
Hinge Flapping Mechanism/metal_dowel_33.SLDPRT
3.30 x 3.24 x 38.0 mm
