etbikehome/Mech_Des_Ornithopter/Hinge Flapping Mechanism/crank_attachment.SLDPRT

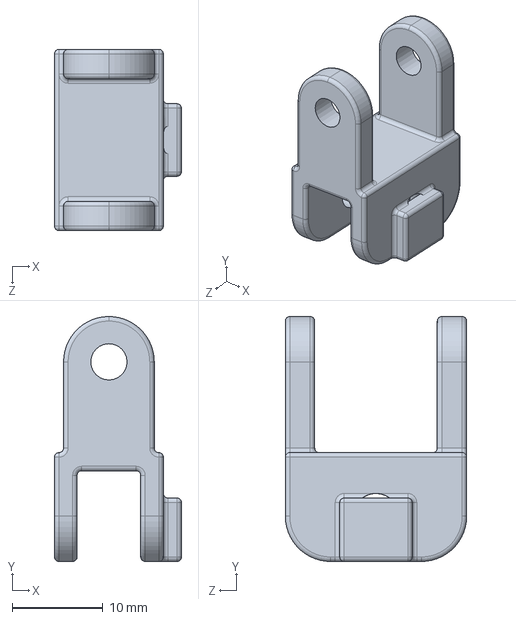
[picture p51: CAD file, 2024-11-18]
Hinge Flapping Mechanism/crank_attachment.SLDPRT
14.0 x 27.0 x 20.0 mm
