etbikehome/Mech_Des_Ornithopter/Hinge Flapping Mechanism/nail_pin.SLDPRT

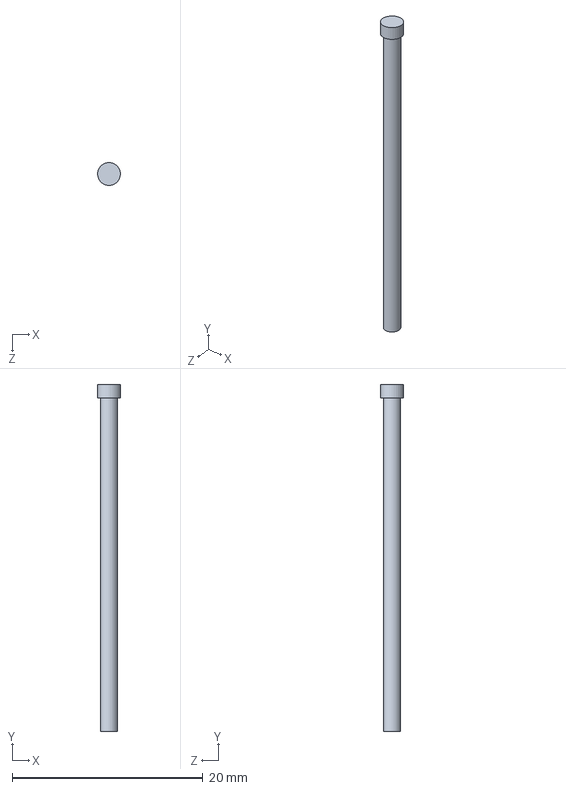
[picture p52: CAD file, 2024-11-18]
Hinge Flapping Mechanism/nail_pin.SLDPRT
2.40 x 36.4 x 2.40 mm
