etbikehome/Mech_Des_Ornithopter/Hinge Flapping Mechanism/endcap.SLDPRT

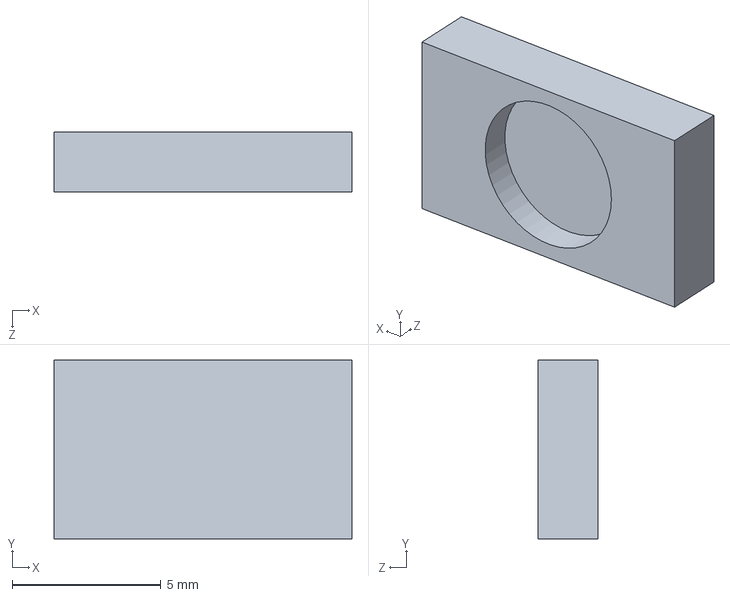
[picture p53: CAD file, 2024-11-18]
Hinge Flapping Mechanism/endcap.SLDPRT
10.0 x 6.00 x 2.00 mm
