etbikehome/Mech_Des_Ornithopter/Hinge Flapping Mechanism/spars.SLDPRT

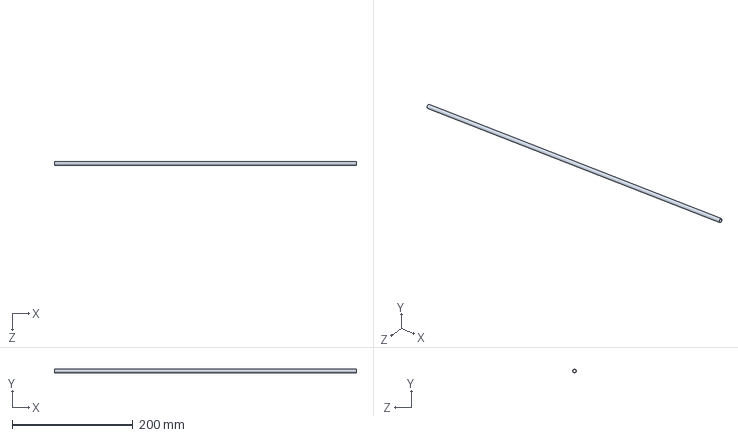
[picture p54: CAD file, 2024-11-14]
Hinge Flapping Mechanism/spars.SLDPRT
500.0 x 6.00 x 6.00 mm
