etbikehome/Mech_Des_Ornithopter/Hinge Flapping Mechanism/placeholder_24mm_gear.SLDPRT

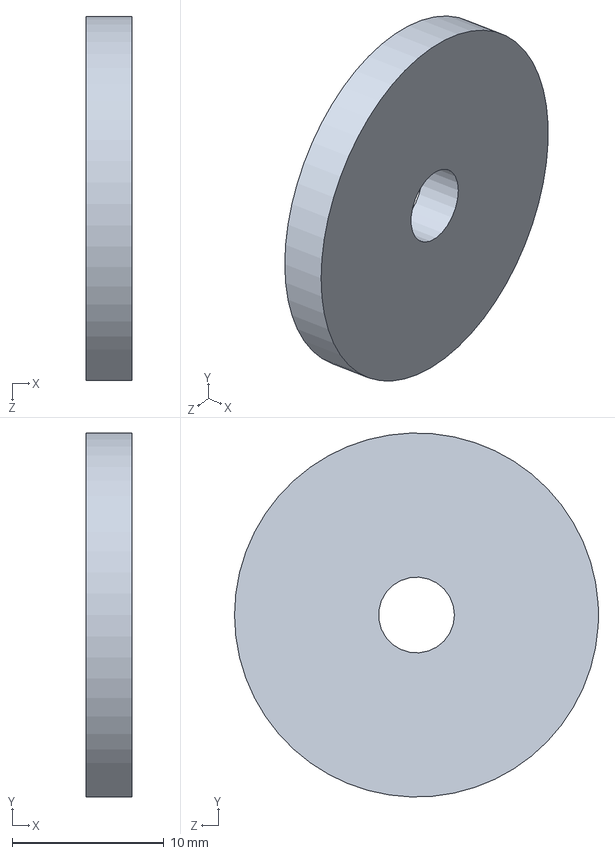
[picture p55: CAD file, 2024-11-14]
Hinge Flapping Mechanism/placeholder_24mm_gear.SLDPRT
3.00 x 24.0 x 24.0 mm
