etbikehome/Mech_Des_Ornithopter/Hinge Flapping Mechanism/plastic_spacer.SLDPRT

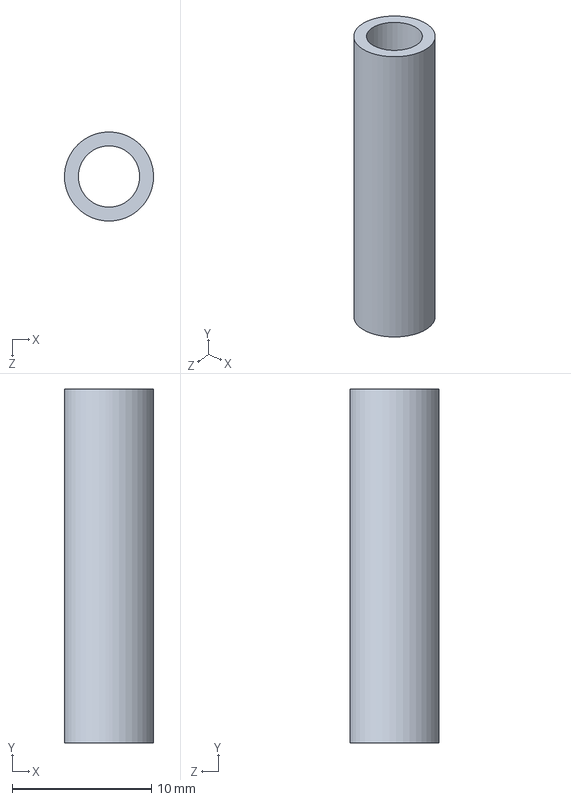
[picture p56: CAD file, 2024-11-14]
Hinge Flapping Mechanism/plastic_spacer.SLDPRT
6.40 x 25.4 x 6.40 mm
