etbikehome/Mech_Des_Ornithopter/Hinge Flapping Mechanism/spar_hinge_frame.SLDPRT

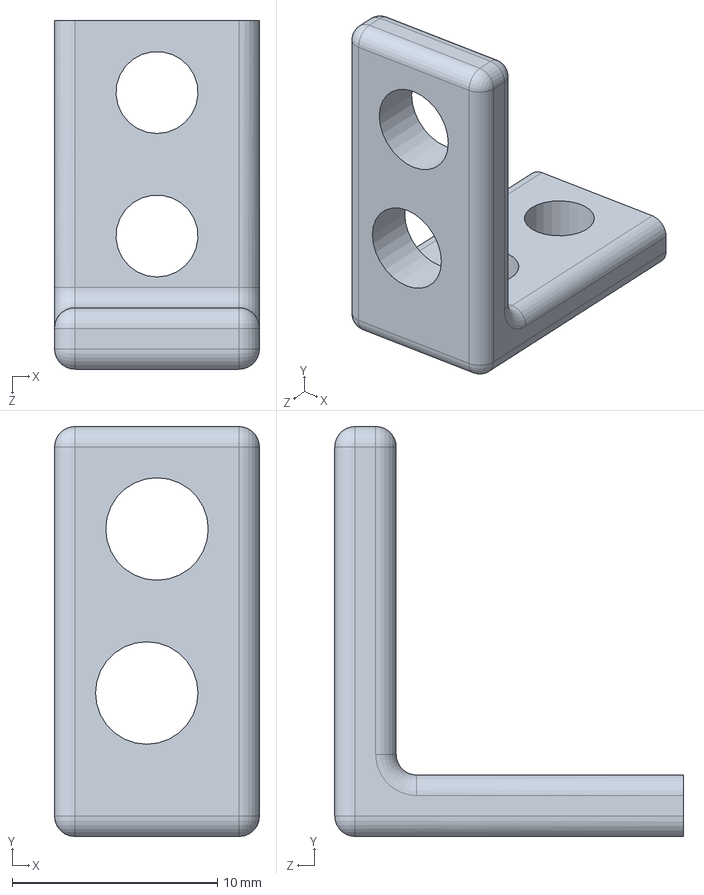
[picture p57: CAD file, 2024-11-14]
Hinge Flapping Mechanism/spar_hinge_frame.SLDPRT
10.0 x 20.0 x 17.0 mm
