etbikehome/Mech_Des_Ornithopter/Hinge Flapping Mechanism/bracket.SLDPRT

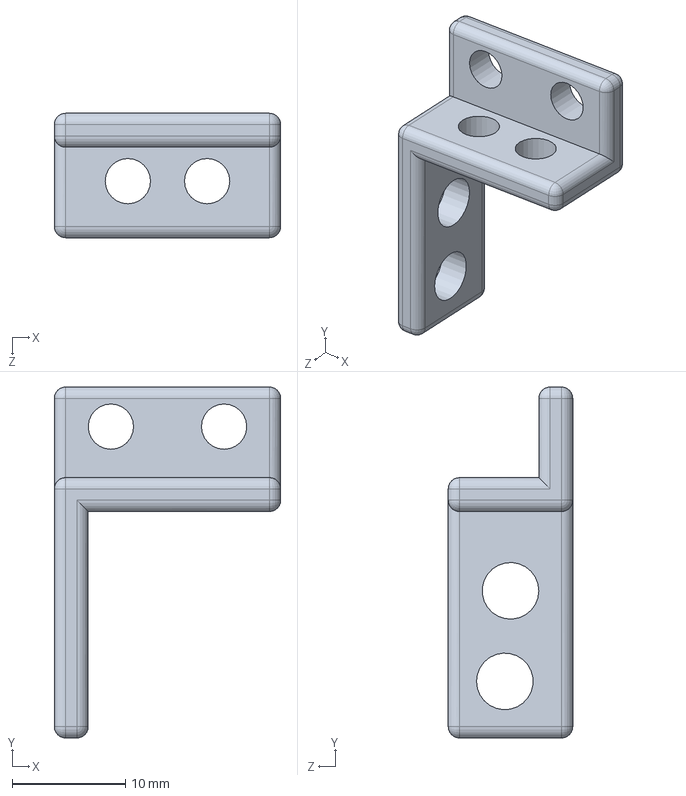
[picture p58: CAD file, 2024-11-14]
Hinge Flapping Mechanism/bracket.SLDPRT
20.0 x 31.0 x 11.0 mm
