etbikehome/Mech_Des_Ornithopter/gearbox/updatedGearbox1_36.SLDASM

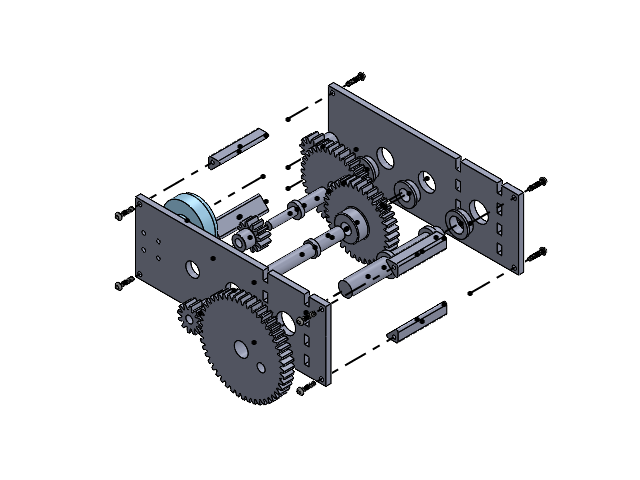
[picture p59: CAD file, 2024-12-19]
gearbox/updatedGearbox1_36.SLDASM
2662N332_20 Degree Pressure Angle Plastic Gear x 3
2662N341_20 Degree Pressure Angle Plastic Gear x 2
2662N343_20 Degree Pressure Angle Plastic Gear
single_6mm_shaft
step_shaft
final_stage_shaft
sideplateA
sideplateB
EMAX 2004 MOTOR
4mm_shaft_bushing
6mm_shaft_bushing x 3
8mm_shaft_bushing x 2
gearbox_standoff x 4
92095A454_Button Head Hex Drive Screw x 8
