etbikehome/Mech_Des_Ornithopter/Hinge Flapping Mechanism/hinge_plate_flapping_plate_version.SLDASM

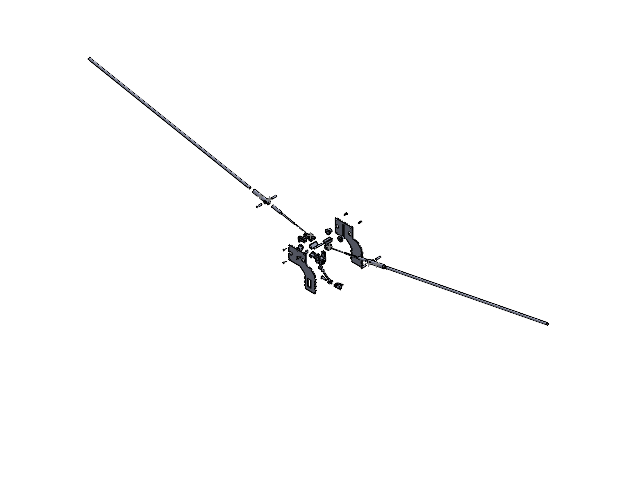
[picture p60: CAD file, 2024-12-20]
Hinge Flapping Mechanism/hinge_plate_flapping_plate_version.SLDASM
spars x 2
cranke_joint_hinge1v2 x 2
nail_pin x 2
metal_dowel_33 x 3
plastic_spacer x 2
crank_attachment
metal_crank_cap
metal_dowel_46
endcap
spar_hinge_interface_v2 x 2
metal_dowel_40 x 4
metal_crank_cap_linkside
delrin_bushing x 4
metal_dowel_33_cut
46_pin
crank_v2
plate_connector x 2
flapping_mech_frames_v2 x 2
plate_connector_tail_mount
92095A454_Button Head Hex Drive Screw x 6
