etbikehome/Mech_Des_Ornithopter/Ornithopter1_36_test.SLDASM

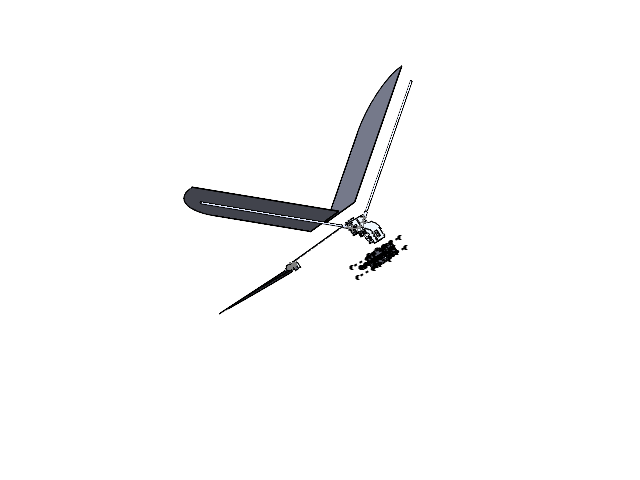
[picture p61: CAD file, 2024-12-20]
Ornithopter1_36_test.SLDASM
spars x 2
cranke_joint_hinge1v2 x 2
nail_pin x 2
metal_dowel_33 x 3
plastic_spacer x 2
crank_attachment
metal_crank_cap
metal_dowel_46
endcap
spar_hinge_interface_v2 x 2
metal_dowel_40 x 4
metal_crank_cap_linkside
delrin_bushing x 4
metal_dowel_33_cut
46_pin
crank_v2
plate_connector x 2
flapping_mech_frames_v2 x 2
plate_connector_tail_mount
92095A454_Button Head Hex Drive Screw x 14
2662N332_20 Degree Pressure Angle Plastic Gear x 3
2662N341_20 Degree Pressure Angle Plastic Gear x 2
2662N343_20 Degree Pressure Angle Plastic Gear
single_6mm_shaft
step_shaft
final_stage_shaft
sideplateA
sideplateB
EMAX 2004 MOTOR
4mm_shaft_bushing
6mm_shaft_bushing x 3
8mm_shaft_bushing x 2
gearbox_standoff x 4
Tail_Ornithopter
Tail Clip rod
Ornithopter Tail Holder 2 with split and support
5.5g Servo x 2
wing_fabric x 2
tail_rod
