etbikehome/Mech_Des_Ornithopter/Ornithopter.SLDASM

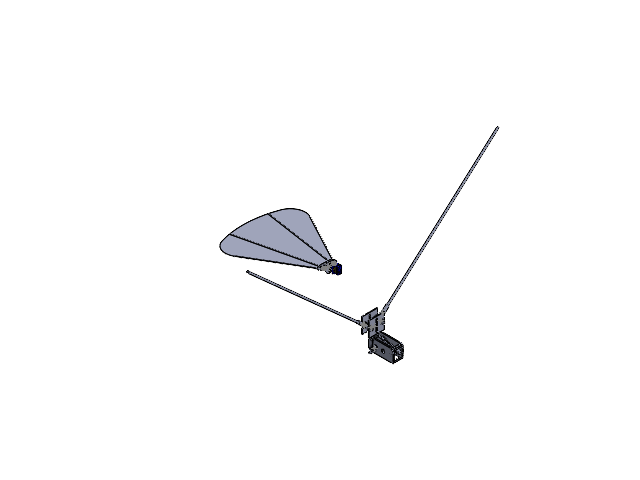
[picture p62: CAD file, 2024-11-21]
Ornithopter.SLDASM
2662N332_20 Degree Pressure Angle Plastic Gear x 2
2662N341_20 Degree Pressure Angle Plastic Gear x 3
motor_1404
sideplateA
motor_adaptor_shaft
step_shaft
single_6mm_shaft
sideplateB
gearbox_standoff x 4
Ornithopter Tail Holder
SG90 - Micro Servo 9g - Tower Pro.1
SG90 - Micro Servo 9g - Tower Pro.3
SG90 - Micro Servo 9g - Tower Pro.5 x 2
SG90 - Micro Servo 9g - Tower Pro.6
Tail_Ornithopter
spars x 2
cranke_joint_hinge1v2 x 2
nail_pin x 2
metal_dowel_33 x 4
plastic_spacer x 2
crank_attachment
metal_crank_cap
metal_dowel_46 x 2
endcap
flapping_mech_frames x 2
spar_hinge_interface_v2 x 2
metal_dowel_40 x 4
crank_linkage_drive
metal_crank_cap_linkside
delrin_bushing x 4
