etbikehome/Mech_Des_Ornithopter/gearbox/2step_12_70.SLDASM

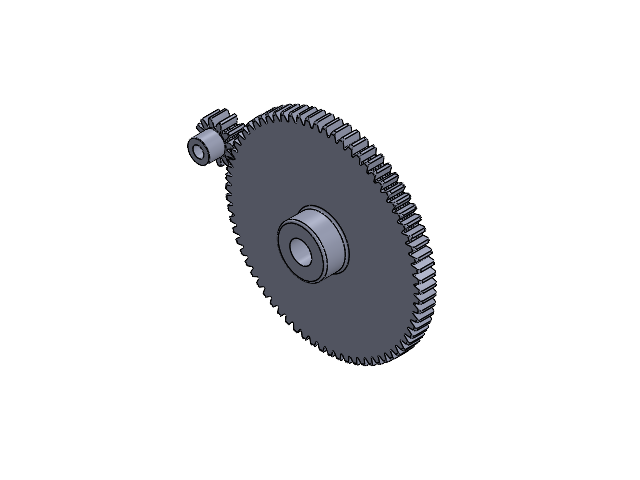
[picture p63: CAD file, 2024-11-30]
gearbox/2step_12_70.SLDASM
2662N332_20 Degree Pressure Angle Plastic Gear
2662N347_20 Degree Pressure Angle Plastic Gear
