etbikehome/Mech_Des_Ornithopter/(list of files, cad)

Other CAD files:
Hinge Flapping Mechanism/metal_dowel_46.SLDPRT
Hinge Flapping Mechanism/crank_pin_drawing_lathe.SLDDRW
Hinge Flapping Mechanism/delrin_bushing_drawing2.SLDDRW
Hinge Flapping Mechanism/flapping_mech_frames.SLDPRT
Hinge Flapping Mechanism/flapping_mech_frames_v2.DXF
Hinge Flapping Mechanism/flapping_mech_frames_v2.SLDDRW
Hinge Flapping Mechanism/flapping_mech_frames_v2_laser_cut.SLDDRW
Hinge Flapping Mechanism/flapping_mech_frames_v2drawing.SLDDRW
Hinge Flapping Mechanism/flapping_mech_frames_v2nohole.DXF
Hinge Flapping Mechanism/hinge_pin_drawing.SLDDRW
Hinge Flapping Mechanism/hinge_plate_flapping_plate_version.SLDDRW
Hinge Flapping Mechanism/spar_hinge_interface.SLDPRT
Hinge Flapping Mechanism/spar_hinge_interface_v2.SLDPRT
Ornithopter1_36_test.SLDDRW
Tail/Ornithopter Tail Assembly.SLDDRW
gearbox/2662N332_20 Degree Pressure Angle Plastic Gear.SLDPRT
gearbox/2662N335_20 Degree Pressure Angle Plastic Gear.SLDPRT
gearbox/2662N341_20 Degree Pressure Angle Plastic Gear.SLDPRT
gearbox/2662N343_20 Degree Pressure Angle Plastic Gear.SLDPRT
gearbox/2662N347_20 Degree Pressure Angle Plastic Gear.SLDPRT
gearbox/6mm_shaft_bushing.SLDDRW
gearbox/8mm_shaft_bushing.SLDDRW
gearbox/92095A454_Button Head Hex Drive Screw.SLDPRT
gearbox/Gears/2662N332_20 Degree Pressure Angle Plastic Gear.SLDPRT
gearbox/Gears/2662N347_20 Degree Pressure Angle Plastic Gear.SLDPRT
gearbox/final_stage_shaft.SLDDRW
gearbox/gearbox_standoff.SLDDRW
gearbox/gearbox_standoff.STL
gearbox/sideplateA.DXF
gearbox/sideplateA.SLDDRW
gearbox/sideplateB.DXF
gearbox/step_shaft.SLDDRW
gearbox/updatedGearbox1_36.SLDDRW
