etbikehome/Mech_Des_Ornithopter/Hinge Flapping Mechanism/Crank Pin Drawing PDF.pdf

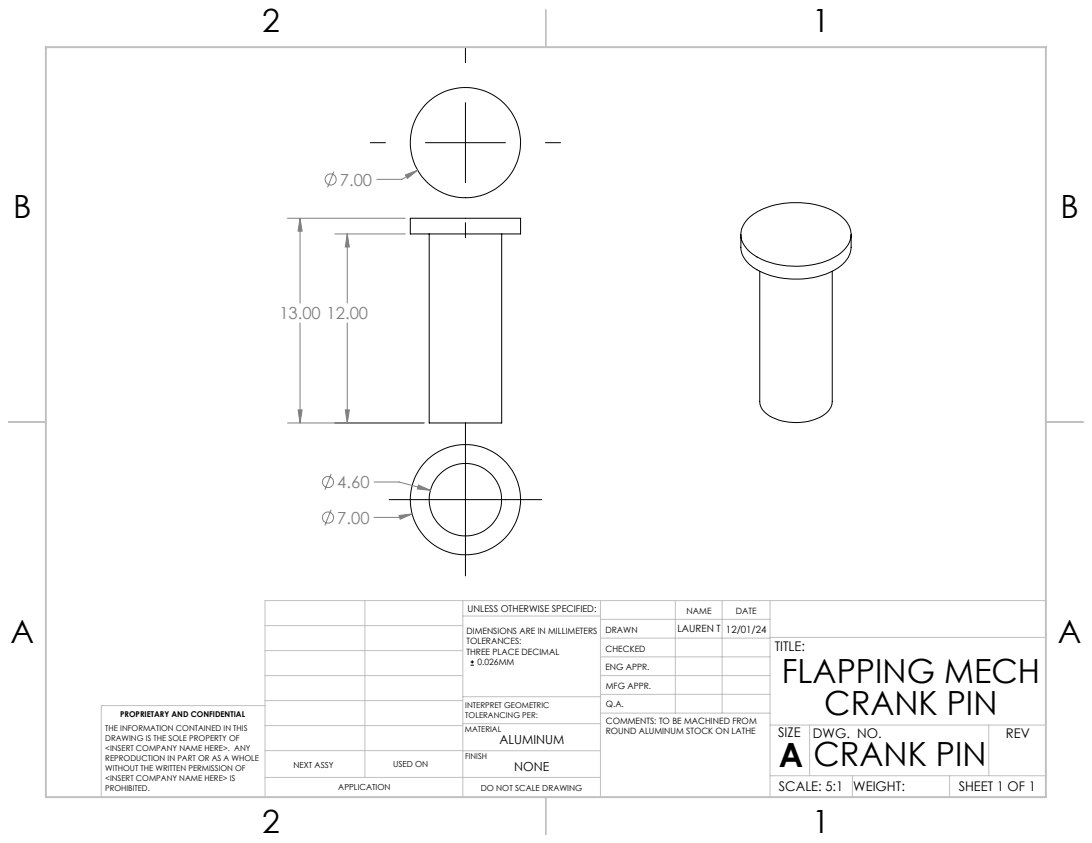
[picture p64: page 1]

UNLESS OTHERWISE SPECIFIED: | | NAME | DATE
DIMENSIONS ARE IN MILLIMETERS TOLERANCES: THREE PLACE DECIMAL 0.026MM | DRAWN | LAUREN T | 12/01/24

CHECKED | | | TITLE: FLAPPING MECH CRANK PIN

ENG APPR.
MFG APPR.

INTERPRET GEOMETRIC TOLERANCING PER: | Q.A.
MATERIAL ALUMINUM | | SIZE A | DWG. NO. CRANK PIN | REV

PROPRIETARY AND CONFIDENTIAL
THE INFORMATION CONTAINED IN THIS
DRAWING IS THE SOLE PROPERTY OF
<INSERT COMPANY NAME HERE>. ANY
REPRODUCTION IN PART OR AS A WHOLE
WITHOUT THE WRITTEN PERMISSION OF
<INSERT COMPANY NAME HERE> IS
PROHIBITED.

COMMENTS: TO BE MACHINED FROM
ROUND ALUMINUM STOCK ON LATHE

NEXT ASSY | USED ON | NONE FINISH

APPLICATION | DO NOT SCALE DRAWING | | SCALE: 5:1 | WEIGHT: | SHEET 1 OF 1
