etbikehome/Mech_Des_Ornithopter/Hinge Flapping Mechanism/Delrin Bushin Drawing PDF.pdf

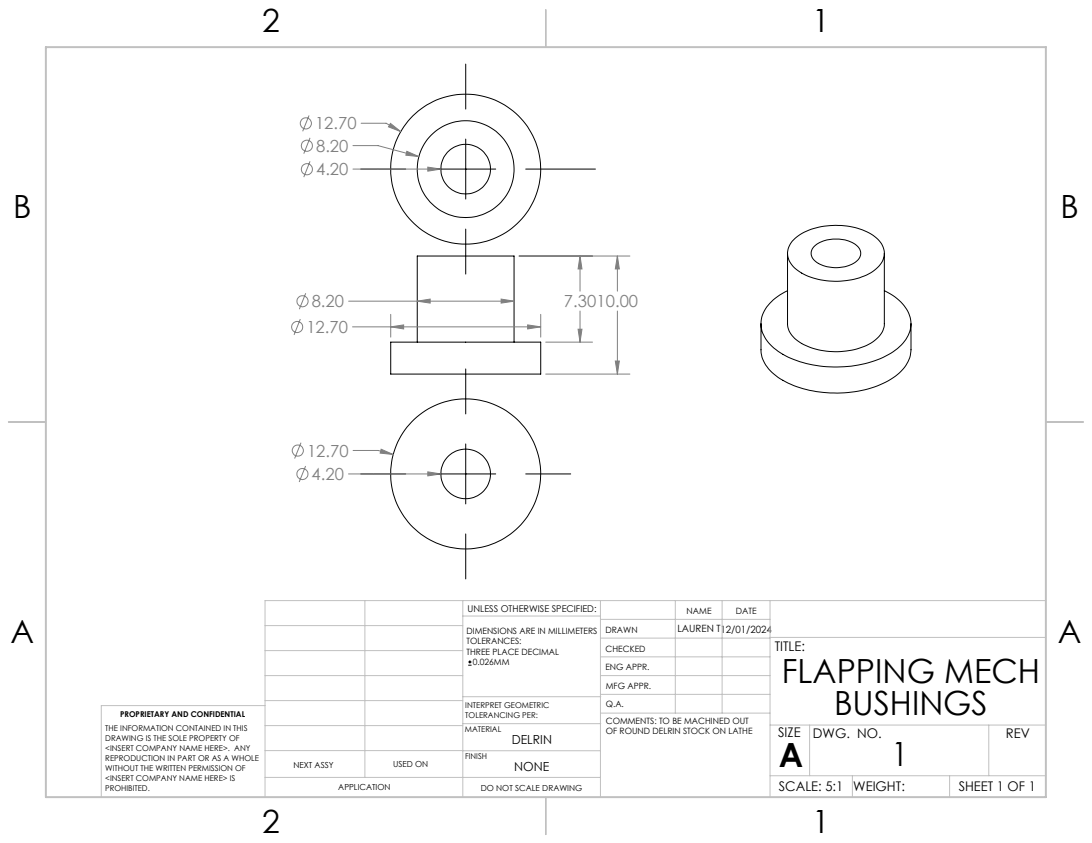
[picture p65: page 1]

UNLESS OTHERWISE SPECIFIED: | | NAME | DATE
DIMENSIONS ARE IN MILLIMETERS TOLERANCES: THREE PLACE DECIMAL 0.026MM | DRAWN | LAUREN T12/01/2024

CHECKED | | | TITLE: FLAPPING MECH BUSHINGS

ENG APPR.
MFG APPR.

INTERPRET GEOMETRIC TOLERANCING PER: | Q.A.
MATERIAL DELRIN | | SIZE A | DWG. NO. 1 | REV

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

COMMENTS: TO BE MACHINED OUT
OF ROUND DELRIN STOCK ON LATHE

NEXT ASSY | USED ON | NONE FINISH

APPLICATION | DO NOT SCALE DRAWING | | SCALE: 5:1 | WEIGHT: | SHEET 1 OF 1
