etbikehome/Mech_Des_Ornithopter/Hinge Flapping Mechanism/Hinge Pin Drawing PDF.PDF

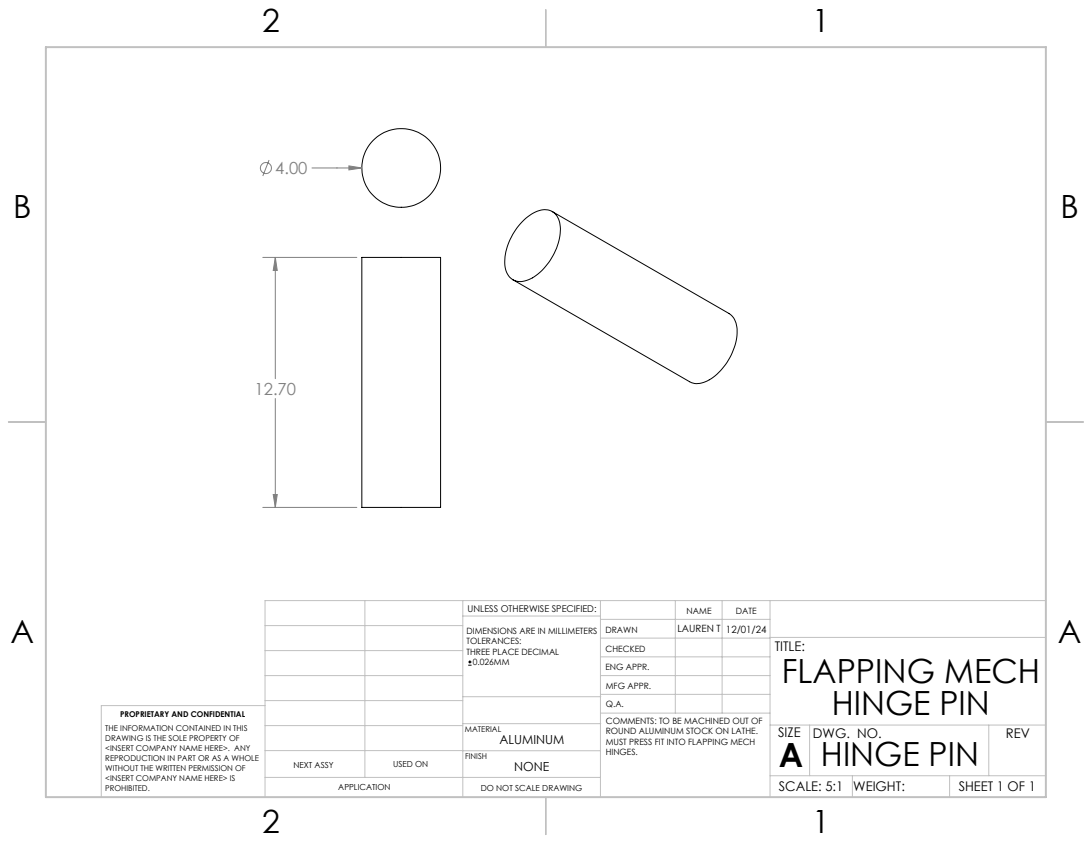
[picture p66: page 1]
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

CHECKED | | | TITLE: FLAPPING MECH HINGE PIN

ENG APPR.
MFG APPR.
Q.A.

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

MATERIAL ALUMINUM | | SIZE A | DWG. NO. HINGE PIN | REV

COMMENTS: TO BE MACHINED OUT OF
ROUND ALUMINUM STOCK ON LATHE.
MUST PRESS FIT INTO FLAPPING MECH
HINGES.

NEXT ASSY | USED ON | NONE FINISH

APPLICATION | DO NOT SCALE DRAWING | | SCALE: 5:1 | WEIGHT: | SHEET 1 OF 1
