etbikehome/Mech_Des_Ornithopter/(commit log)

2024-10-31 Added gears from McMaster
    [2662N27_20 Degree Pressure Angle Plastic Gear.SLDPRT, 2662N319_20 Degree Pressure Angle Plastic Gear.SLDPRT, 2662N332_20 Degree Pressure Angle Plastic Gear.SLDPRT, 2662N347_20 Degree Pressure Angle Plastic Gear.SLDPRT]
2024-11-04 Added motor CAD
    [motor_1404.SLDPRT]
2024-11-04 Add gearbox
    [1_36_3StepV2.SLDASM, 2662N332_20 Degree Pressure Angle Plastic Gear.SLDPRT, 2662N335_20 Degree Pressure Angle Plastic Gear.SLDPRT, 2662N341_20 Degree Pressure Angle Plastic Gear.SLDPRT, 2662N343_20 Degree Pressure Angle Plastic Gear.SLDPRT]
2024-11-08 Add 1/9 gear ratio assembly with motor
    [1_36_3StepV2.SLDASM, 1_9.SLDASM]
2024-11-11 Full gearbox with motor and shafts
    [1_9.SLDASM, 2662N332_20 Degree Pressure Angle Plastic Gear.SLDPRT, 2662N341_20 Degree Pressure Angle Plastic Gear.SLDPRT, motor_1404.SLDPRT, motor_adaptor_shaft.SLDPRT, sideplateA.SLDPRT, sideplateB.SLDPRT, single_6mm_shaft.SLDPRT]
2024-11-11 Rename gearbox assembly
    [1_9.SLDASM, Gearbox.SLDASM]
2024-11-14 Add tail cad
    [Ornithopter Tail Assembly.SLDASM, Ornithopter Tail Holder.SLDPRT, SG90 - Micro Servo 9g - Tower Pro.SLDASM, Tail_Ornithopter.SLDPRT]
2024-11-14 uploaded flapping mech cad
    non-finalized flapping mech cad
    [2662N341_20 Degree Pressure Angle Plastic Gear.SLDPRT, Gearbox.SLDASM, bracket.SLDPRT, crank_attachment.SLDPRT, cranke_joint_hinge1v2.SLDPRT, endcap.SLDPRT, hinge_plate_flapping_assembly.SLDASM, metal_crank_cap.SLDPRT]
2024-11-18 cleaned flapping cad
    [Gearbox.SLDASM, crank_attachment.SLDPRT, cranke_joint_hinge1v2.SLDPRT, endcap.SLDPRT, flapping_mech_frames.SLDPRT, hinge_plate_flapping_assembly.SLDASM, hinge_plate_flapping_plate_version.SLDASM, metal_crank_cap.SLDPRT]
2024-11-18 Add Tail
    [Gearbox.SLDASM, Ornithopter Tail Assembly.SLDASM, Ornithopter Tail Holder.SLDPRT, Ornithopter.SLDASM, SG90 - Micro Servo 9g - Tower Pro.1.SLDPRT, SG90 - Micro Servo 9g - Tower Pro.3.SLDPRT, SG90 - Micro Servo 9g - Tower Pro.5.SLDPRT, SG90 - Micro Servo 9g - Tower Pro.6.SLDPRT]
2024-11-18 updated flapping mech
    updated flapping mechanism to use plates + include bushings. Also added basic crank linkage.
    [bushing_mount.SLDPRT, crank_linkage_drive.SLDPRT, flapping_mech_frames.SLDPRT, hinge_plate_flapping_assembly.SLDASM, hinge_plate_flapping_plate_version.SLDASM, metal_crank_cap_linkside.SLDPRT, metal_dowel_4.SLDPRT, metal_dowel_40.SLDPRT]
2024-11-18 Update gearbox
    [Gearbox.SLDASM, Ornithopter.SLDASM, motor_adaptor_shaft.SLDPRT, sideplateA.DXF, sideplateA.SLDPRT, sideplateB.DXF, sideplateB.SLDPRT, single_6mm_shaft.SLDPRT]
2024-11-18 Standoff triangles
    [Gearbox.SLDASM, gearbox_standoff.SLDPRT, gearbox_standoff.STL, sideplateA.DXF, sideplateA.SLDPRT, sideplateB.SLDPRT]
2024-11-21 updated plate flapping mechanism
    [delrin_bushing.SLDPRT, hinge_plate_flapping_plate_version.SLDASM]
2024-11-21 Fix gearbox
    [Gearbox.SLDASM, gearbox_standoff.SLDPRT]
2024-11-21 drawing for flapping mech delrin bushing
    [delrin_bushing_drawing.SLDDRW]
2024-11-21 Sort Parts into folders
    [1_36_3StepV2.SLDASM, 2662N27_20 Degree Pressure Angle Plastic Gear.SLDPRT, 2662N319_20 Degree Pressure Angle Plastic Gear.SLDPRT, 2662N332_20 Degree Pressure Angle Plastic Gear.SLDPRT, 2662N335_20 Degree Pressure Angle Plastic Gear.SLDPRT, 2662N341_20 Degree Pressure Angle Plastic Gear.SLDPRT, 2662N343_20 Degree Pressure Angle Plastic Gear.SLDPRT, 2662N347_20 Degree Pressure Angle Plastic Gear.SL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]
2024-11-21 Remap full assembly files
    [Gearbox.SLDASM, Ornithopter Tail Assembly.SLDASM, Ornithopter.SLDASM, SG90 - Micro Servo 9g - Tower Pro.SLDASM]
2024-11-21 changed connecting link in flapping mech
    [hinge_plate_flapping_plate_version.SLDASM, metal_dowel_33_cut.SLDPRT]
2024-11-21 Connect Gearbox to flapping
    [Gearbox.SLDASM, Ornithopter.SLDASM]
2024-11-21 updated delrin bushing
    [delrin_bushing.SLDPRT, delrin_bushing_drawing.SLDDRW, hinge_plate_flapping_plate_version.SLDASM]
2024-11-30 1:36 ration
    [2662N332_20 Degree Pressure Angle Plastic Gear.SLDPRT, 2662N341_20 Degree Pressure Angle Plastic Gear.SLDPRT, 2662N343_20 Degree Pressure Angle Plastic Gear.SLDPRT, 2662N347_20 Degree Pressure Angle Plastic Gear.SLDPRT, 2step_12_70.SLDASM, Gearbox.SLDASM, Ornithopter1_36_test.SLDASM, hinge_plate_flapping_plate_version.SLDASM]
2024-12-02 1:36 update
    [Ornithopter1_36_test.SLDASM, final_stage_shaft.SLDPRT, sideplateA.SLDPRT, sideplateB.SLDPRT, single_6mm_shaft.SLDPRT, step_shaft.SLDPRT]
2024-12-02 updated flapping mech with pin
    [46_pin.SLDPRT, crank_linkage_drive.SLDPRT]
2024-12-02 Added emax motor
    [EMAX 2204 MOTOR.sldprt]
2024-12-02 Add 1:36 ratio
    [Ornithopter1_36_test.SLDASM, final_stage_shaft.SLDPRT, updatedGearbox1_36.SLDASM]
2024-12-02 made new crank
    [2662N343_20 Degree Pressure Angle Plastic Gear.SLDPRT, Ornithopter1_36_test.SLDASM, crank_linkage_drive.SLDPRT, crank_v2.SLDPRT, hinge_plate_flapping_plate_version.SLDASM, updatedGearbox1_36.SLDASM]
2024-12-02 Start jointing for flapping
    [Ornithopter1_36_test.SLDASM, sideplateA.SLDPRT, sideplateB.SLDPRT, updatedGearbox1_36.SLDASM]
2024-12-02 updated flapping mech plates
    [flapping_mech_frames.SLDPRT, hinge_plate_flapping_plate_version.SLDASM]
2024-12-04 added plate connectors to flapping mech
    [crank_v2.SLDPRT, hinge_plate_flapping_plate_version.SLDASM, plate_connector.SLDPRT]
2024-12-04 started changing plates for flapping mech
    [Ornithopter1_36_test.SLDASM, flapping_mech_frames.SLDPRT, flapping_mech_frames_v2.SLDPRT, hinge_plate_flapping_plate_version.SLDASM, updatedGearbox1_36.SLDASM]
2024-12-05 put together rough full CAD
    Note: there are several errors/issues that need resolving
    [Ornithopter1_36_test.SLDASM, flapping_mech_frames_v2.SLDPRT, hinge_plate_flapping_plate_version.SLDASM, sideplateB.SLDPRT, updatedGearbox1_36.SLDASM, wing_fabric.SLDPRT]
2024-12-05 Update gearbox sizing
    [Ornithopter1_36_test.SLDASM, final_stage_shaft.SLDPRT, flapping_mech_frames_v2.SLDPRT, hinge_plate_flapping_plate_version.SLDASM, updatedGearbox1_36.SLDASM]
2024-12-05 added cut for gear in flapping mech plates
    [Ornithopter1_36_test.SLDASM, flapping_mech_frames_v2.SLDPRT, flapping_mech_frames_v2_laser_cut.SLDDRW, flapping_mech_frames_v2_no_hole.SLDPRT, hinge_plate_flapping_plate_version.SLDASM, updatedGearbox1_36.SLDASM]
2024-12-09 Fix gearbox and interfacing
    [4mm_shaft_bushing.SLDPRT, 6mm_shaft_bushing.SLDPRT, 8mm_shaft_bushing.SLDPRT, EMAX 2004 MOTOR.sldprt, EMAX 2204 MOTOR.sldprt, Ornithopter1_36_test.SLDASM, flapping_mech_frames_v2.DXF, flapping_mech_frames_v2.SLDPRT]
2024-12-11 changed metal crank cap
    [flapping_mech_frames_v2_laser_cut.SLDDRW, metal_crank_cap.SLDPRT]
2024-12-11 made adjustments to flapping mech plates and made tail rod mount
    [Ornithopter1_36_test.SLDASM, flapping_mech_frames_v2.SLDPRT, flapping_mech_frames_v2_laser_cut.SLDDRW, hinge_plate_flapping_plate_version.SLDASM, plate_connector_tail_mount.SLDPRT]
2024-12-13 Uploaded Tail
    [Ornithopter Tail Assembly.SLDASM, Ornithopter Tail Holder 2 with split and support.SLDPRT, Tail Clip rod.SLDPRT, Tail_Ornithopter.SLDPRT]
2024-12-13 added updated tail to assembly
    [Ornithopter1_36_test.SLDASM, hinge_plate_flapping_plate_version.SLDASM, tail_rod.SLDPRT, updatedGearbox1_36.SLDASM]
2024-12-13 Tail Updates
    [5.5g Servo.SLDPRT, Ornithopter Tail Assembly.SLDASM, Tail_Ornithopter.SLDPRT]
2024-12-14 resolved errors in assemblies
    [Ornithopter Tail Holder 2 with split and support.SLDPRT, Ornithopter1_36_test.SLDASM, Tail_Ornithopter.SLDPRT, hinge_plate_flapping_plate_version.SLDASM, updatedGearbox1_36.SLDASM]
2024-12-14 made 3 parts drawings for flapping mech
    [crank_pin_drawing_lathe.SLDDRW, delrin_bushing_drawing.SLDDRW, delrin_bushing_drawing2.SLDDRW, hinge_pin_drawing.SLDDRW]
2024-12-17 Add drawings
    [8mm_shaft_bushing.SLDDRW, final_stage_shaft.SLDDRW, sideplateA.SLDDRW]
2024-12-17 Update Gearbox wit screws
    [92095A454_Button Head Hex Drive Screw.SLDPRT, Ornithopter1_36_test.SLDASM, final_stage_shaft.SLDDRW, updatedGearbox1_36.SLDASM]
2024-12-18 created alternate spar interfaces
    [flapping_mech_frames_v2.SLDDRW, flapping_mech_frames_v2.SLDPRT, flapping_mech_frames_v2drawing.SLDDRW, spar_hinge_interface_v3.SLDPRT]
2024-12-19 Added drawings and started exploded
    [6mm_shaft_bushing.SLDDRW, Ornithopter1_36_test.SLDASM, Ornithopter1_36_test.SLDDRW, gearbox_standoff.SLDDRW, hinge_plate_flapping_plate_version.SLDASM, step_shaft.SLDDRW, updatedGearbox1_36.SLDASM]
2024-12-19 Added more exploded drawings
    [Ornithopter Tail Assembly.SLDASM, Ornithopter Tail Assembly.SLDDRW, updatedGearbox1_36.SLDASM, updatedGearbox1_36.SLDDRW]
2024-12-19 fixed flapping mech assembly and added bolts
    [flapping_mech_frames_v2.SLDPRT, hinge_plate_flapping_plate_version.SLDASM]
2024-12-20 Finalized drawings
    [Ornithopter Tail Assembly.SLDASM, Ornithopter1_36_test.SLDASM, Ornithopter1_36_test.SLDDRW, hinge_plate_flapping_plate_version.SLDASM]
2024-12-20 Added file for flapping plate thingydingus
    [hinge_plate_flapping_plate_version.SLDDRW]
